jusii/amigahid-pico-UX/doc/images/ux-rev1-iso.png

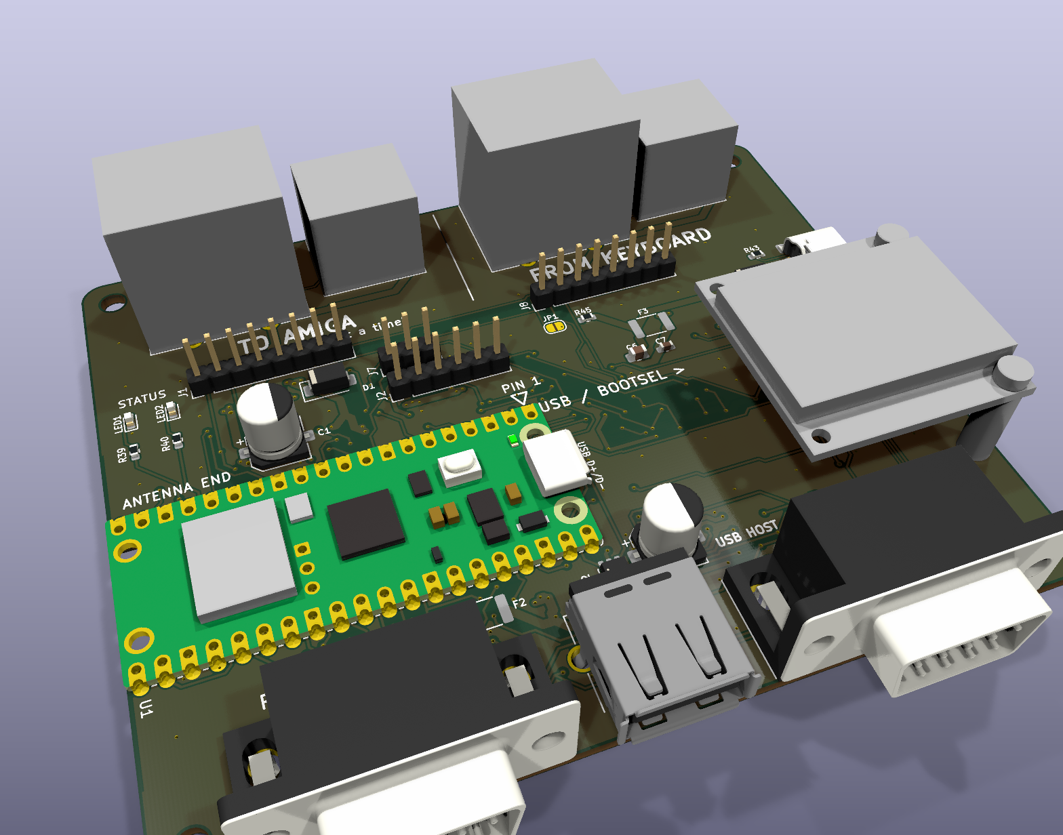
doc/images/ux-rev1-iso.png
