jusii/amigahid-pico-UX/kicad/rev6/mech/hid-pico-amiga-ux-rev1-assembly.step

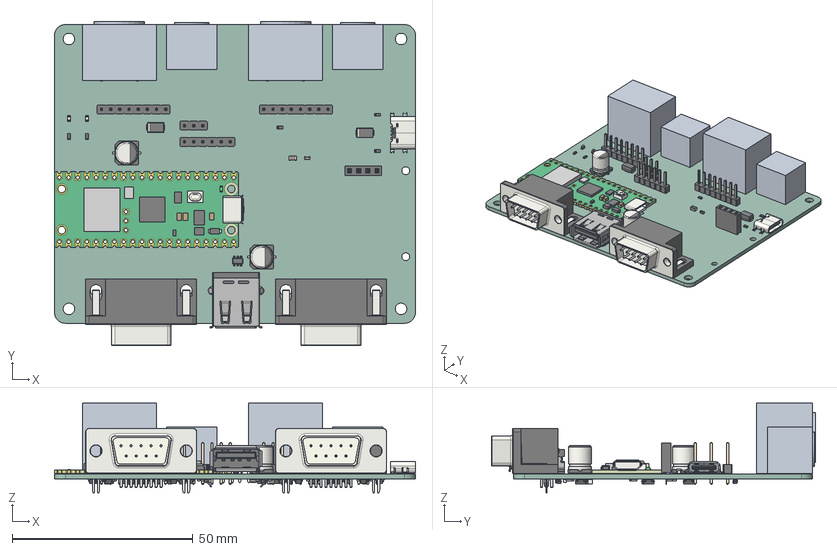
[picture p5: CAD file, 2026-09-28]
kicad/rev6/mech/hid-pico-amiga-ux-rev1-assembly.step
100.0 x 89.7 x 24.9 mm
R_0603_1608Metric x 45
DSUB-9_Pins_Horizontal_P2.77x2.84mm_EdgePinOffset7.70mm_Housed_ MountingHolesOffset9.12mm x 2
CP_Elec_63x77 x 2
PinSocket_1x04_P2.54mm_Vertical
SOT-23-6
USB_C_Receptacle_6P_TopMnt_Horizontal_GCT_USB4135-GF-A
RaspberryPi_Pico_W_Module_KiCad
C_0603_1608Metric x 3
C_0805_2012Metric x 2
LED_0603_1608Metric x 2
D_SMA x 2
PinHeader_1x03_P254mm_Vertical
PinHeader_1x08_P254mm_Vertical x 2
PinHeader_1x06_P254mm_Vertical
USB_A_Molex_67643_Horizontal
SOT-23 x 19
D_SOD-323 x 21
amigahid-pico-rev6_PCB
