jusii/amigahid-pico-UX/kicad/rev6/mech/hid-pico-amiga-ux-rev1-board.step

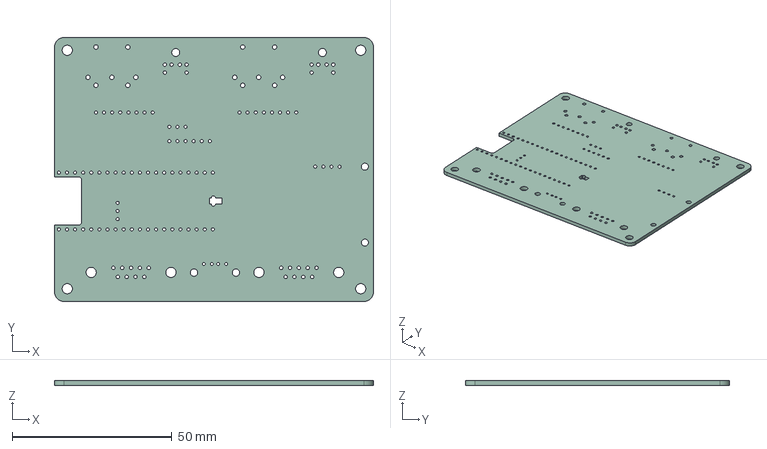
[picture p6: CAD file, 2026-09-28]
kicad/rev6/mech/hid-pico-amiga-ux-rev1-board.step
100.0 x 82.8 x 1.51 mm
