jusii/amigahid-pico-UX/(list of files, cad)

Other CAD files:
kicad/rev6/mech/hid-pico-amiga-ux-rev1-board.stl
