jusii/amigahid-pico-UX/kicad/rev6/fab/fit-check-1to1.pdf

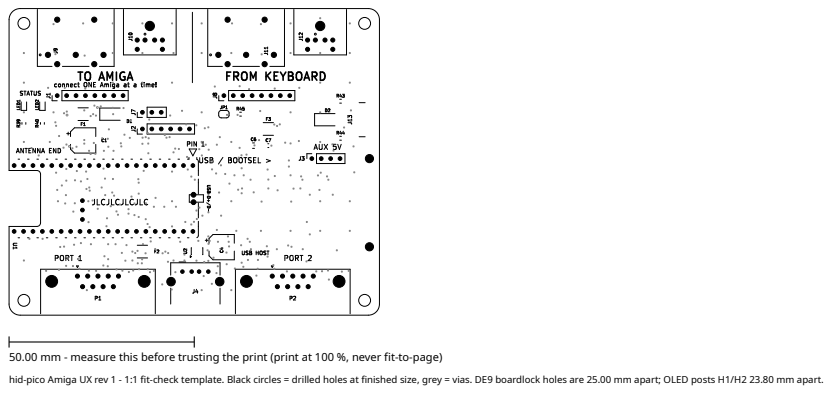
[picture p7: page 1]

50.00 mm - measure this before trusting the print (print at 100 %, never fit-to-page)
hid-pico Amiga UX rev 1 - 1:1 fit-check template. Black circles = drilled holes at finished size, grey = vias. DE9 boardlock holes are 25.00 mm apart; OLED posts H1/H2 23.80 mm apart.
