jusii/amigahid-pico-UX/kicad/rev6/amigahid-pico-rev6.kicad_pcb

## KiCad design kicad/rev6/amigahid-pico-rev6.kicad_pcb (2026-09-28)

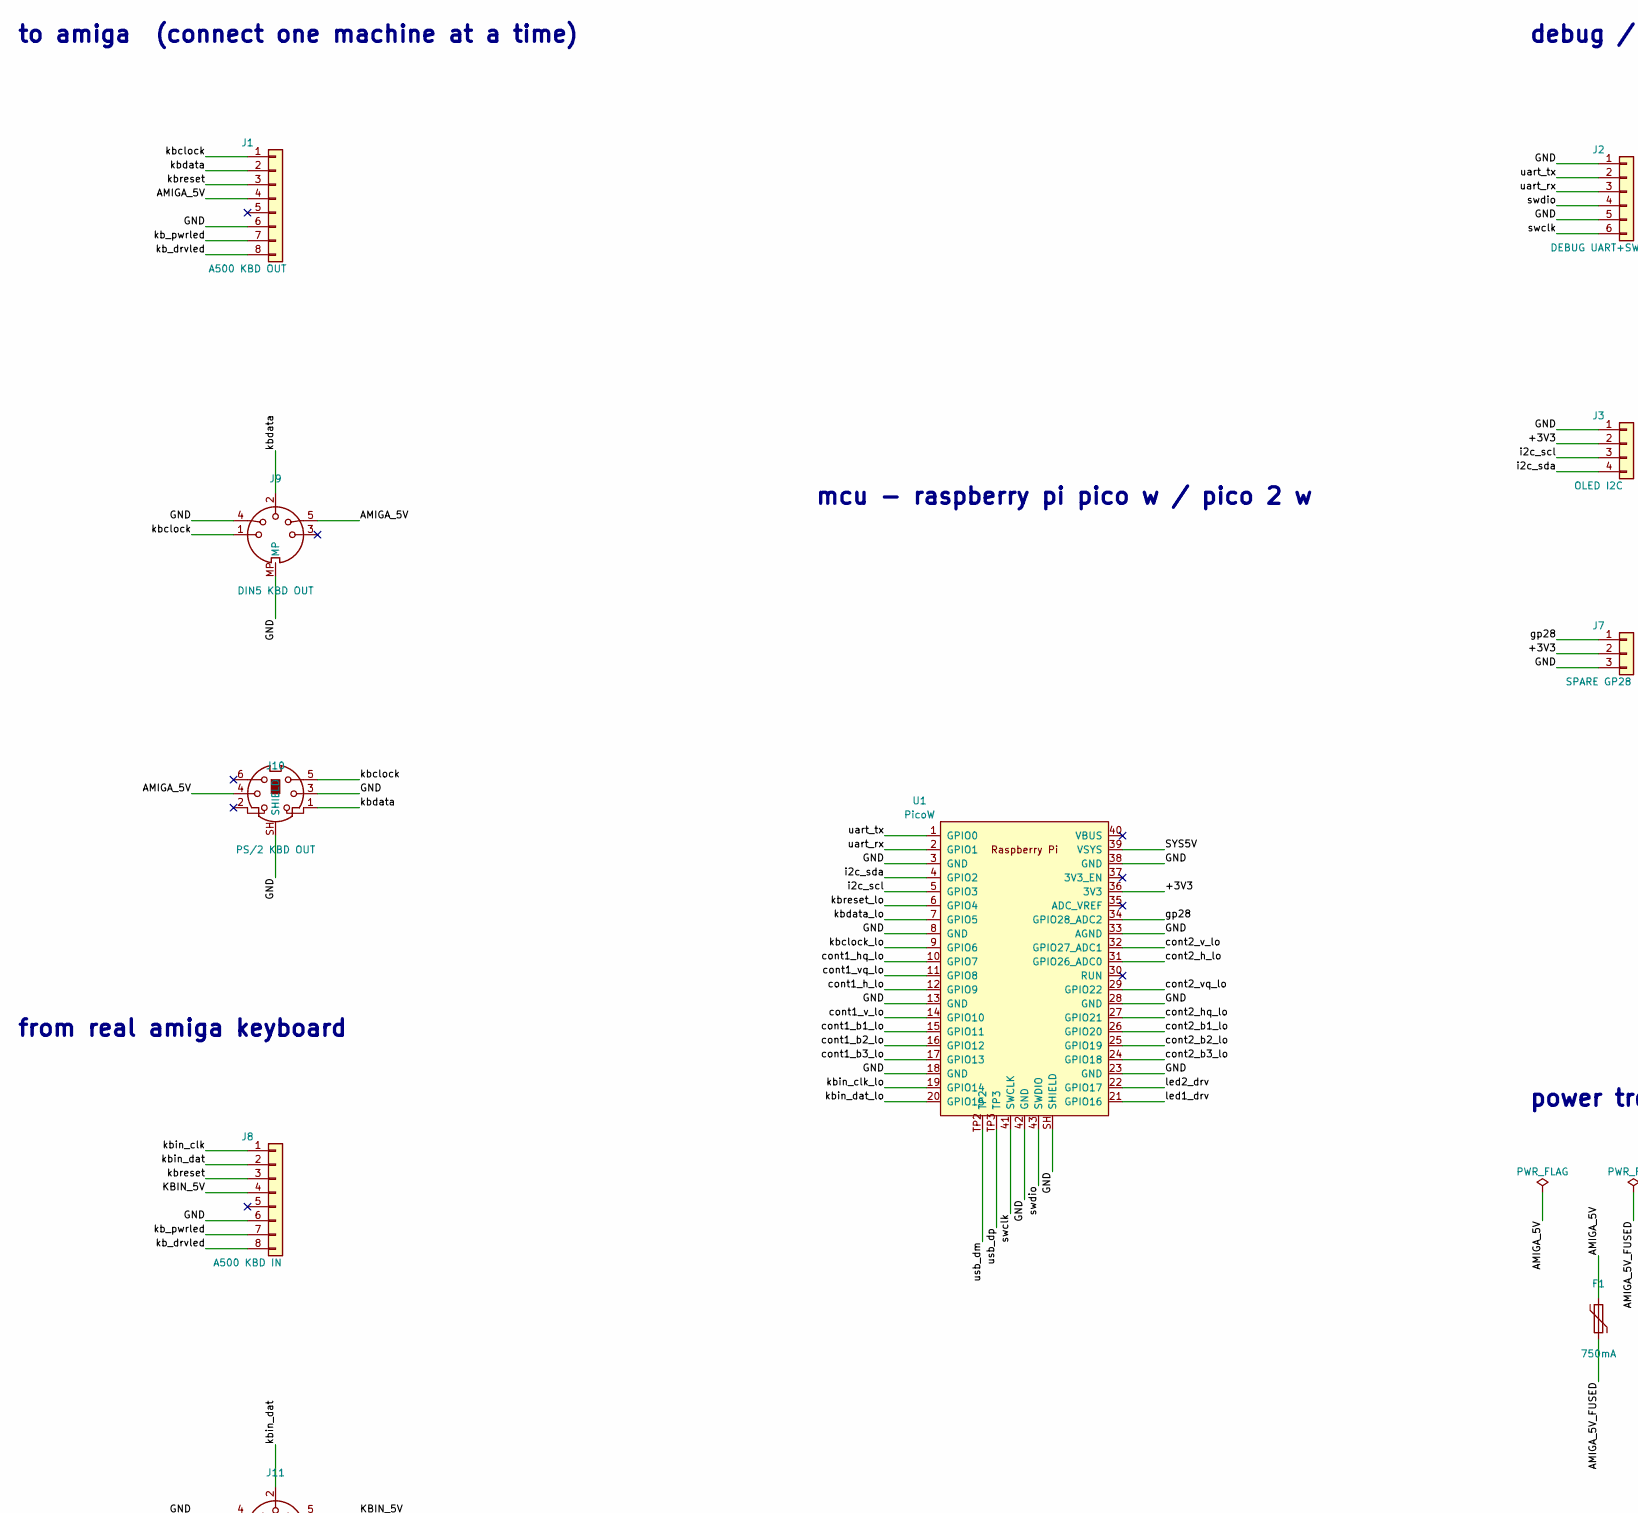
[picture p8: schematic amigahid-pico-rev6.kicad_sch, amiga keyboard adapter, part in row 1, column 1]

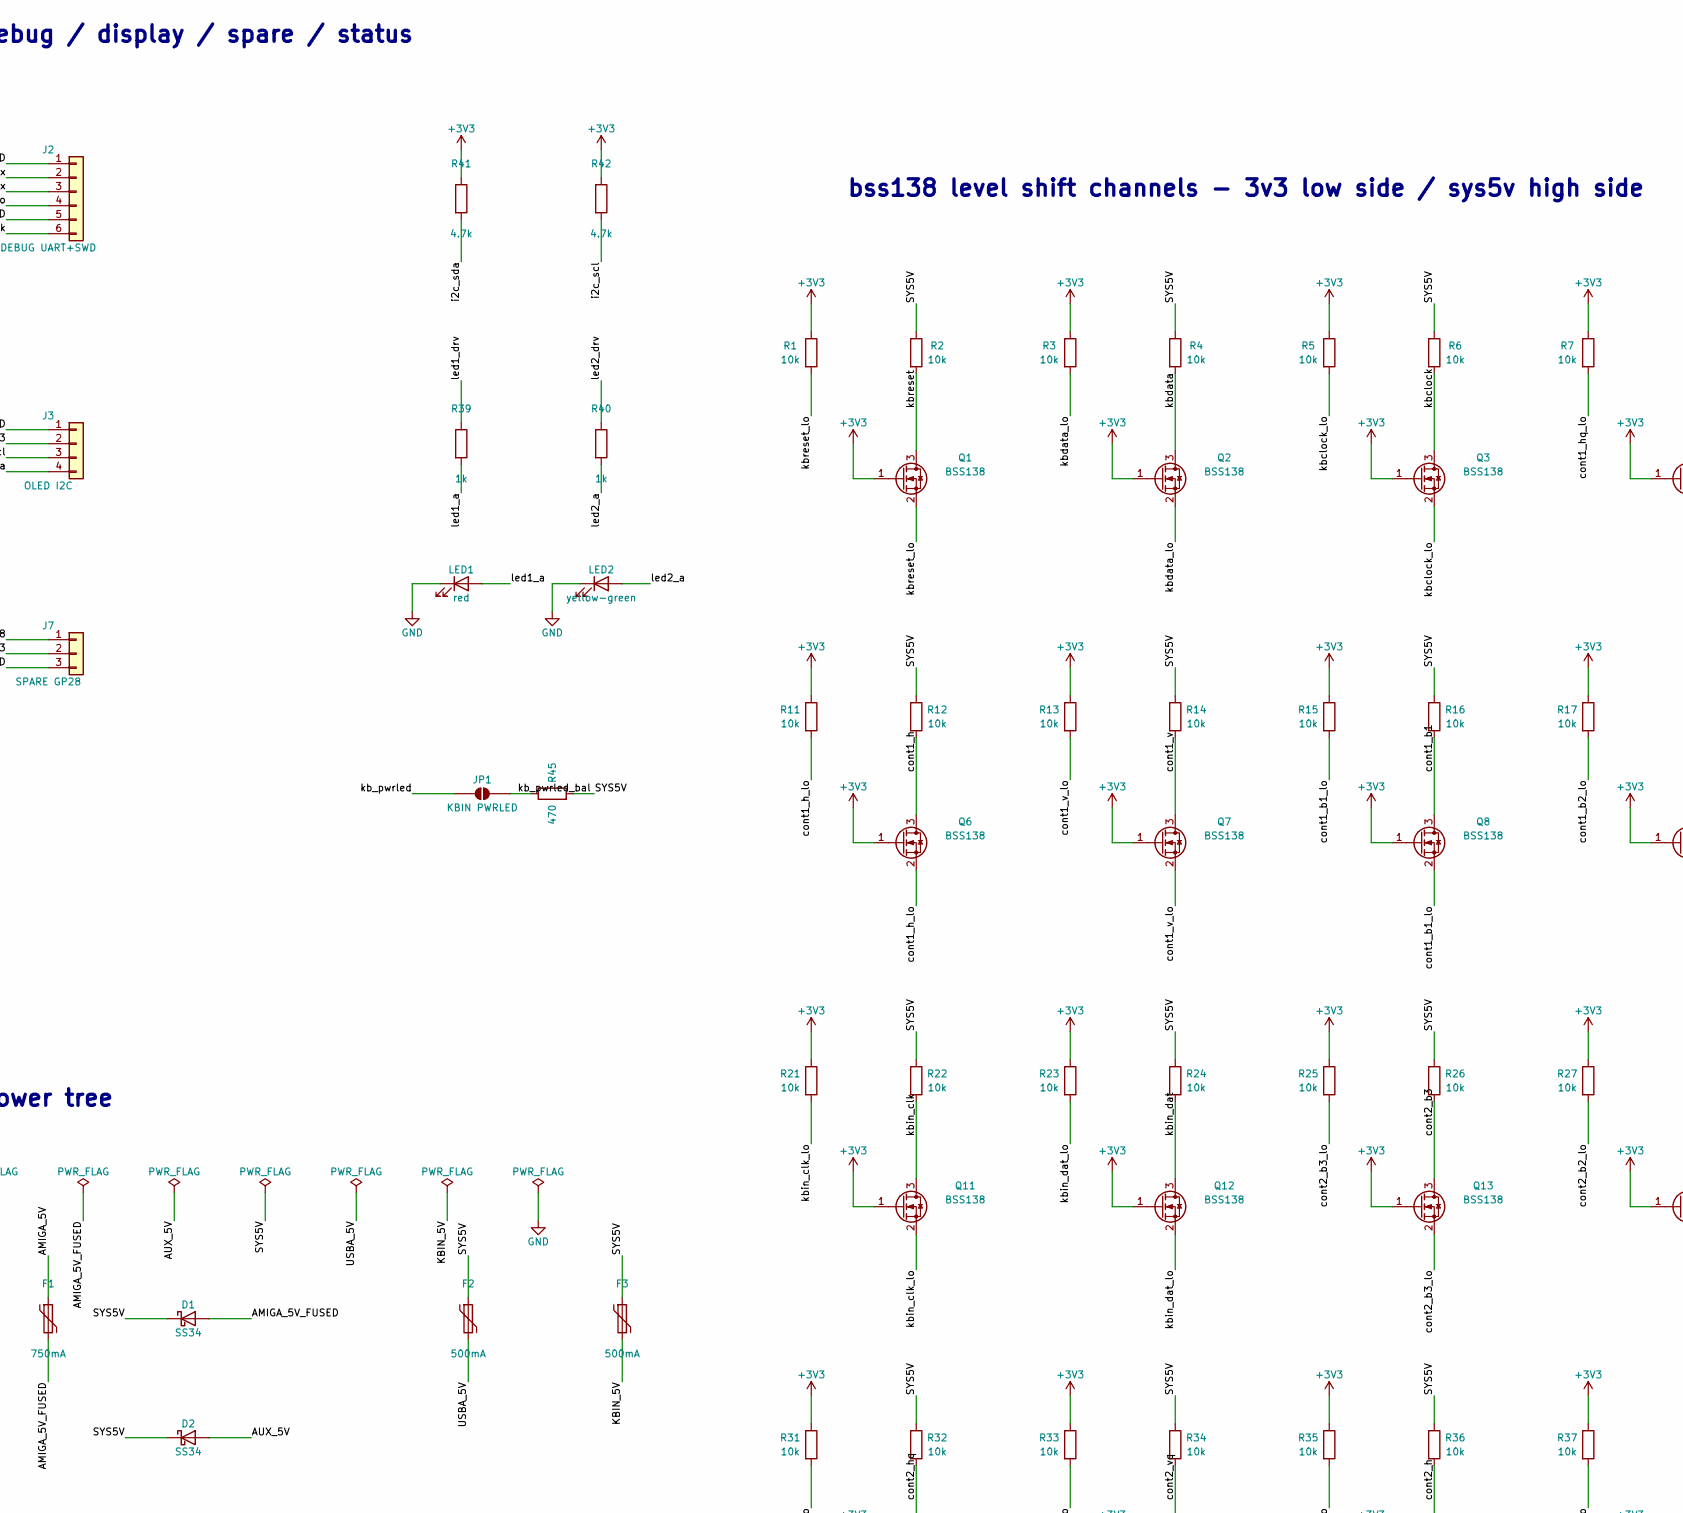
[picture p9: schematic amigahid-pico-rev6.kicad_sch, amiga keyboard adapter, part in row 1, column 2]

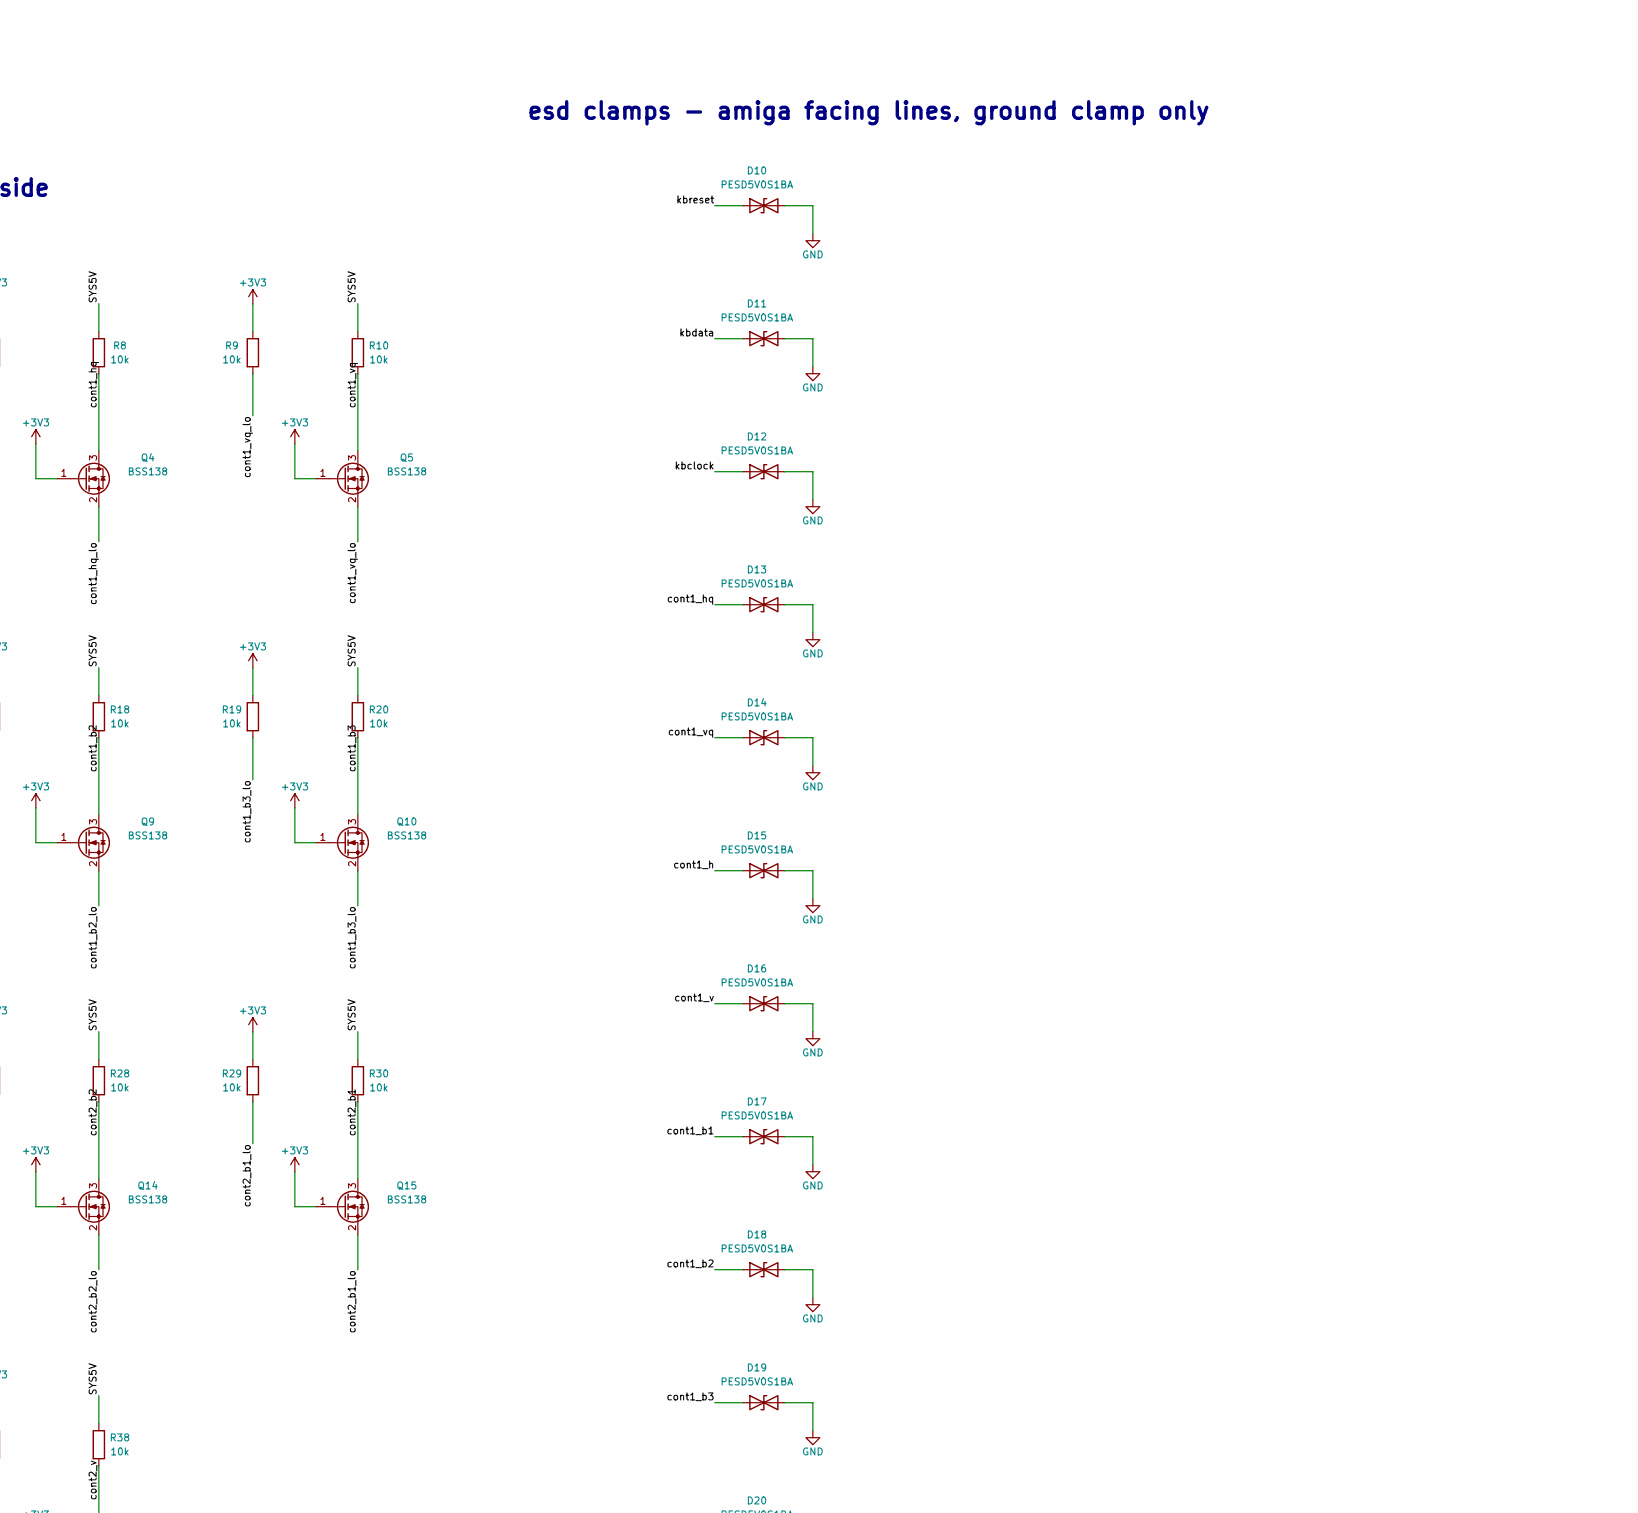
[picture p10: schematic amigahid-pico-rev6.kicad_sch, amiga keyboard adapter, part in row 1, column 3]

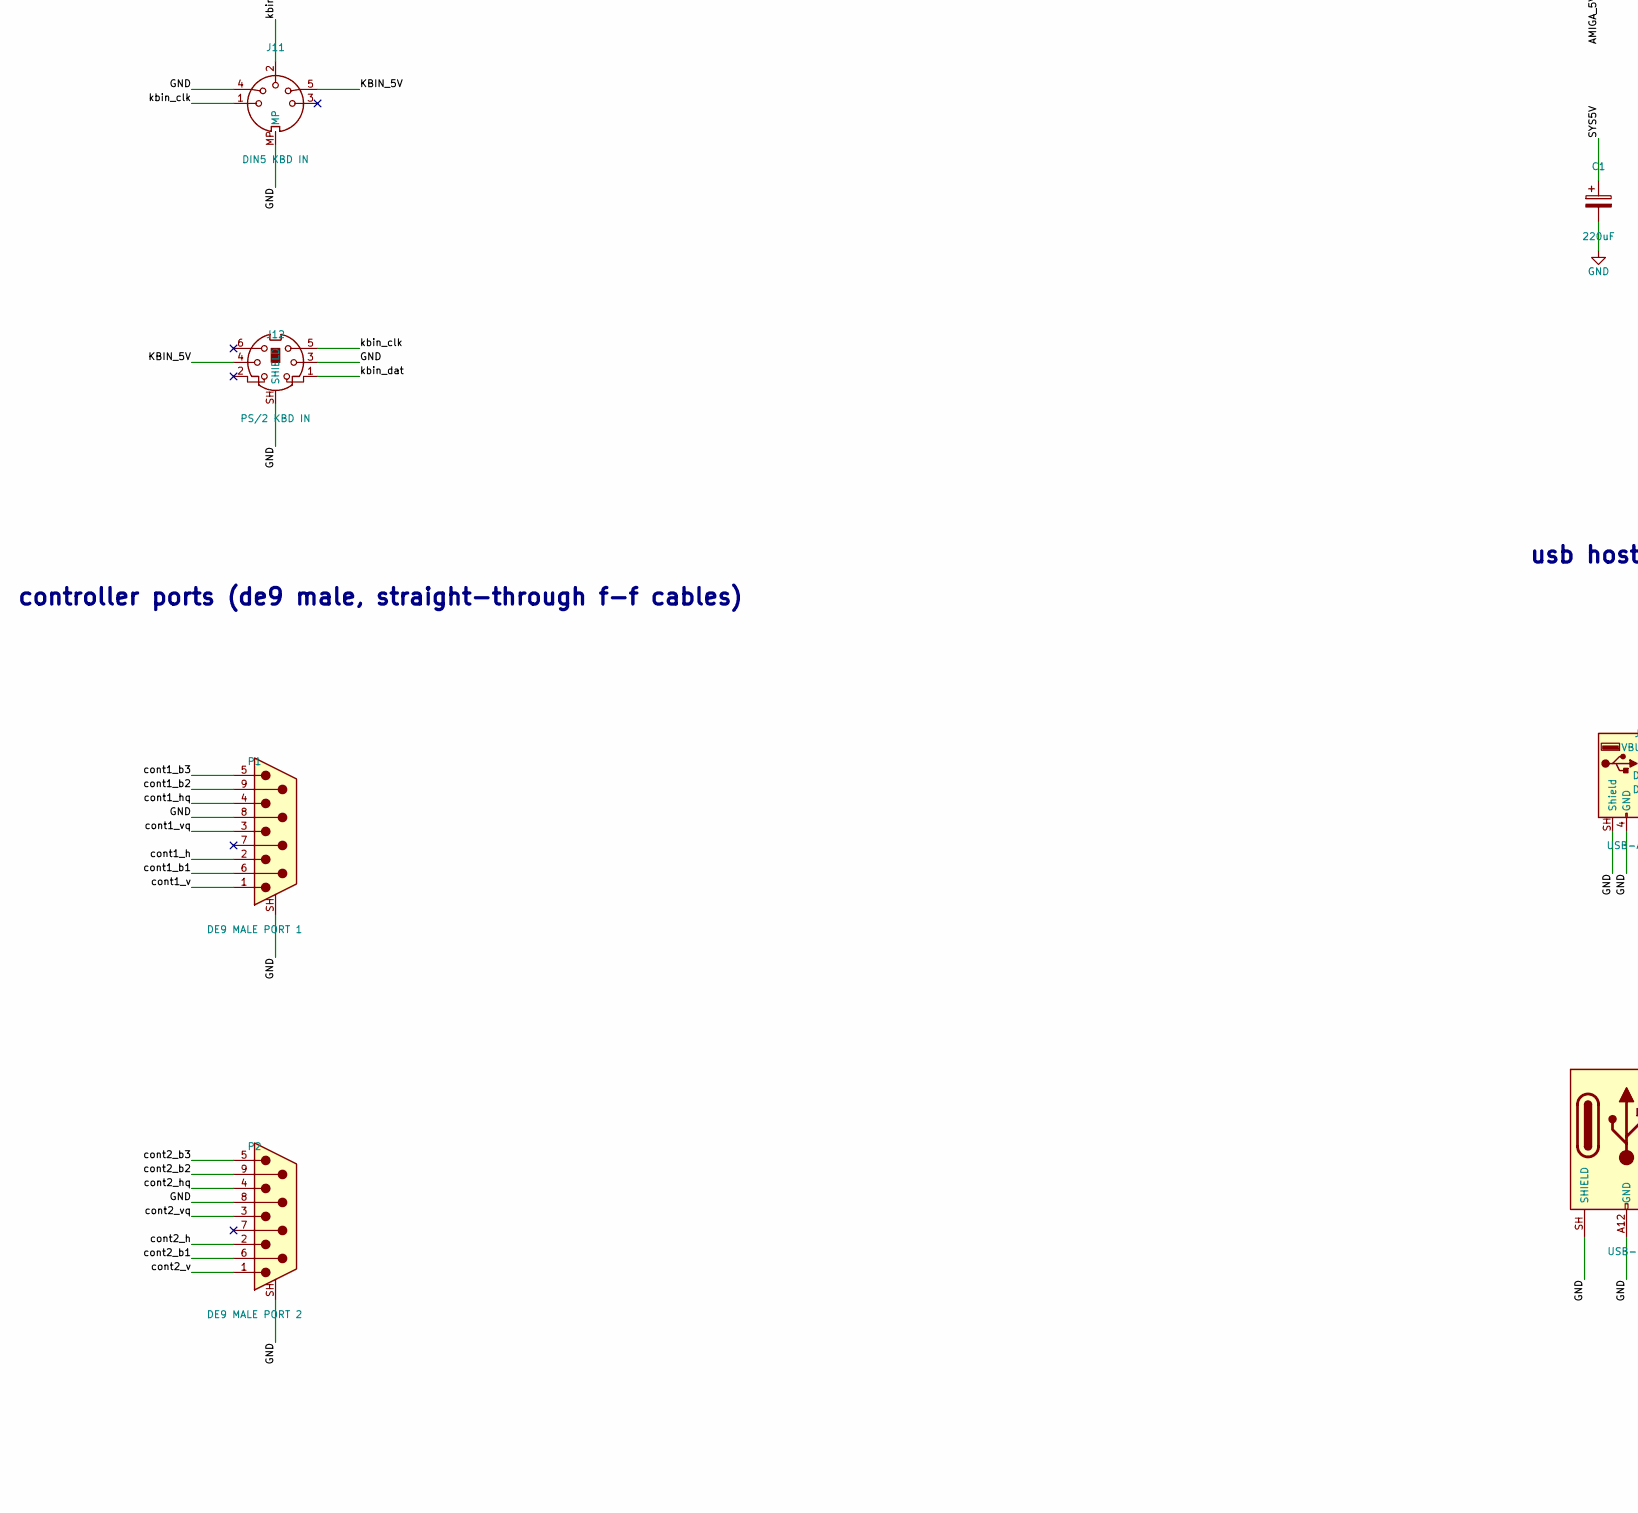
[picture p11: schematic amigahid-pico-rev6.kicad_sch, amiga keyboard adapter, part in row 2, column 1]

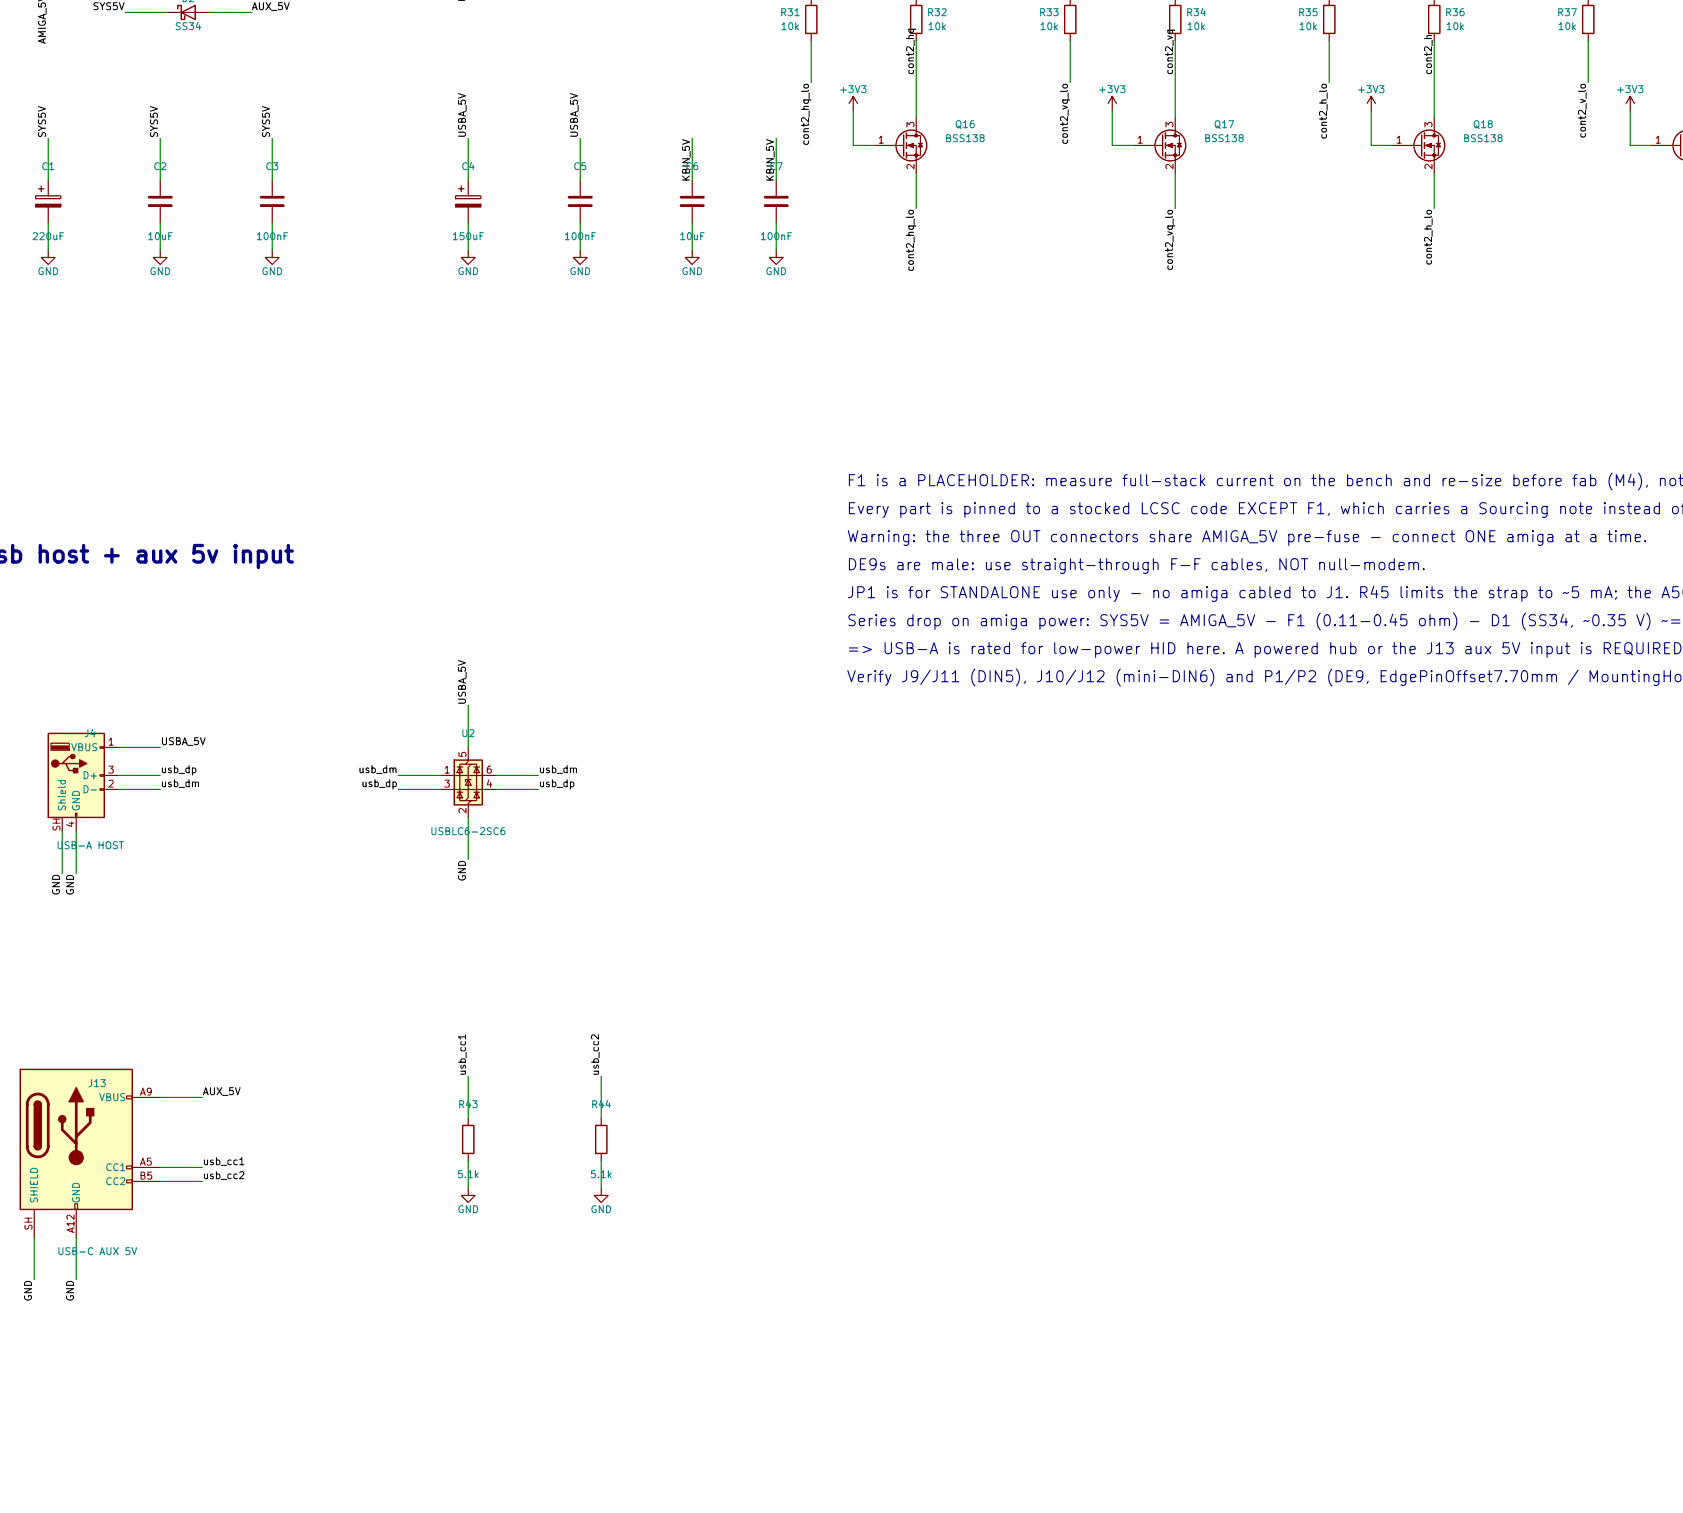
[picture p12: schematic amigahid-pico-rev6.kicad_sch, amiga keyboard adapter, part in row 2, column 2]

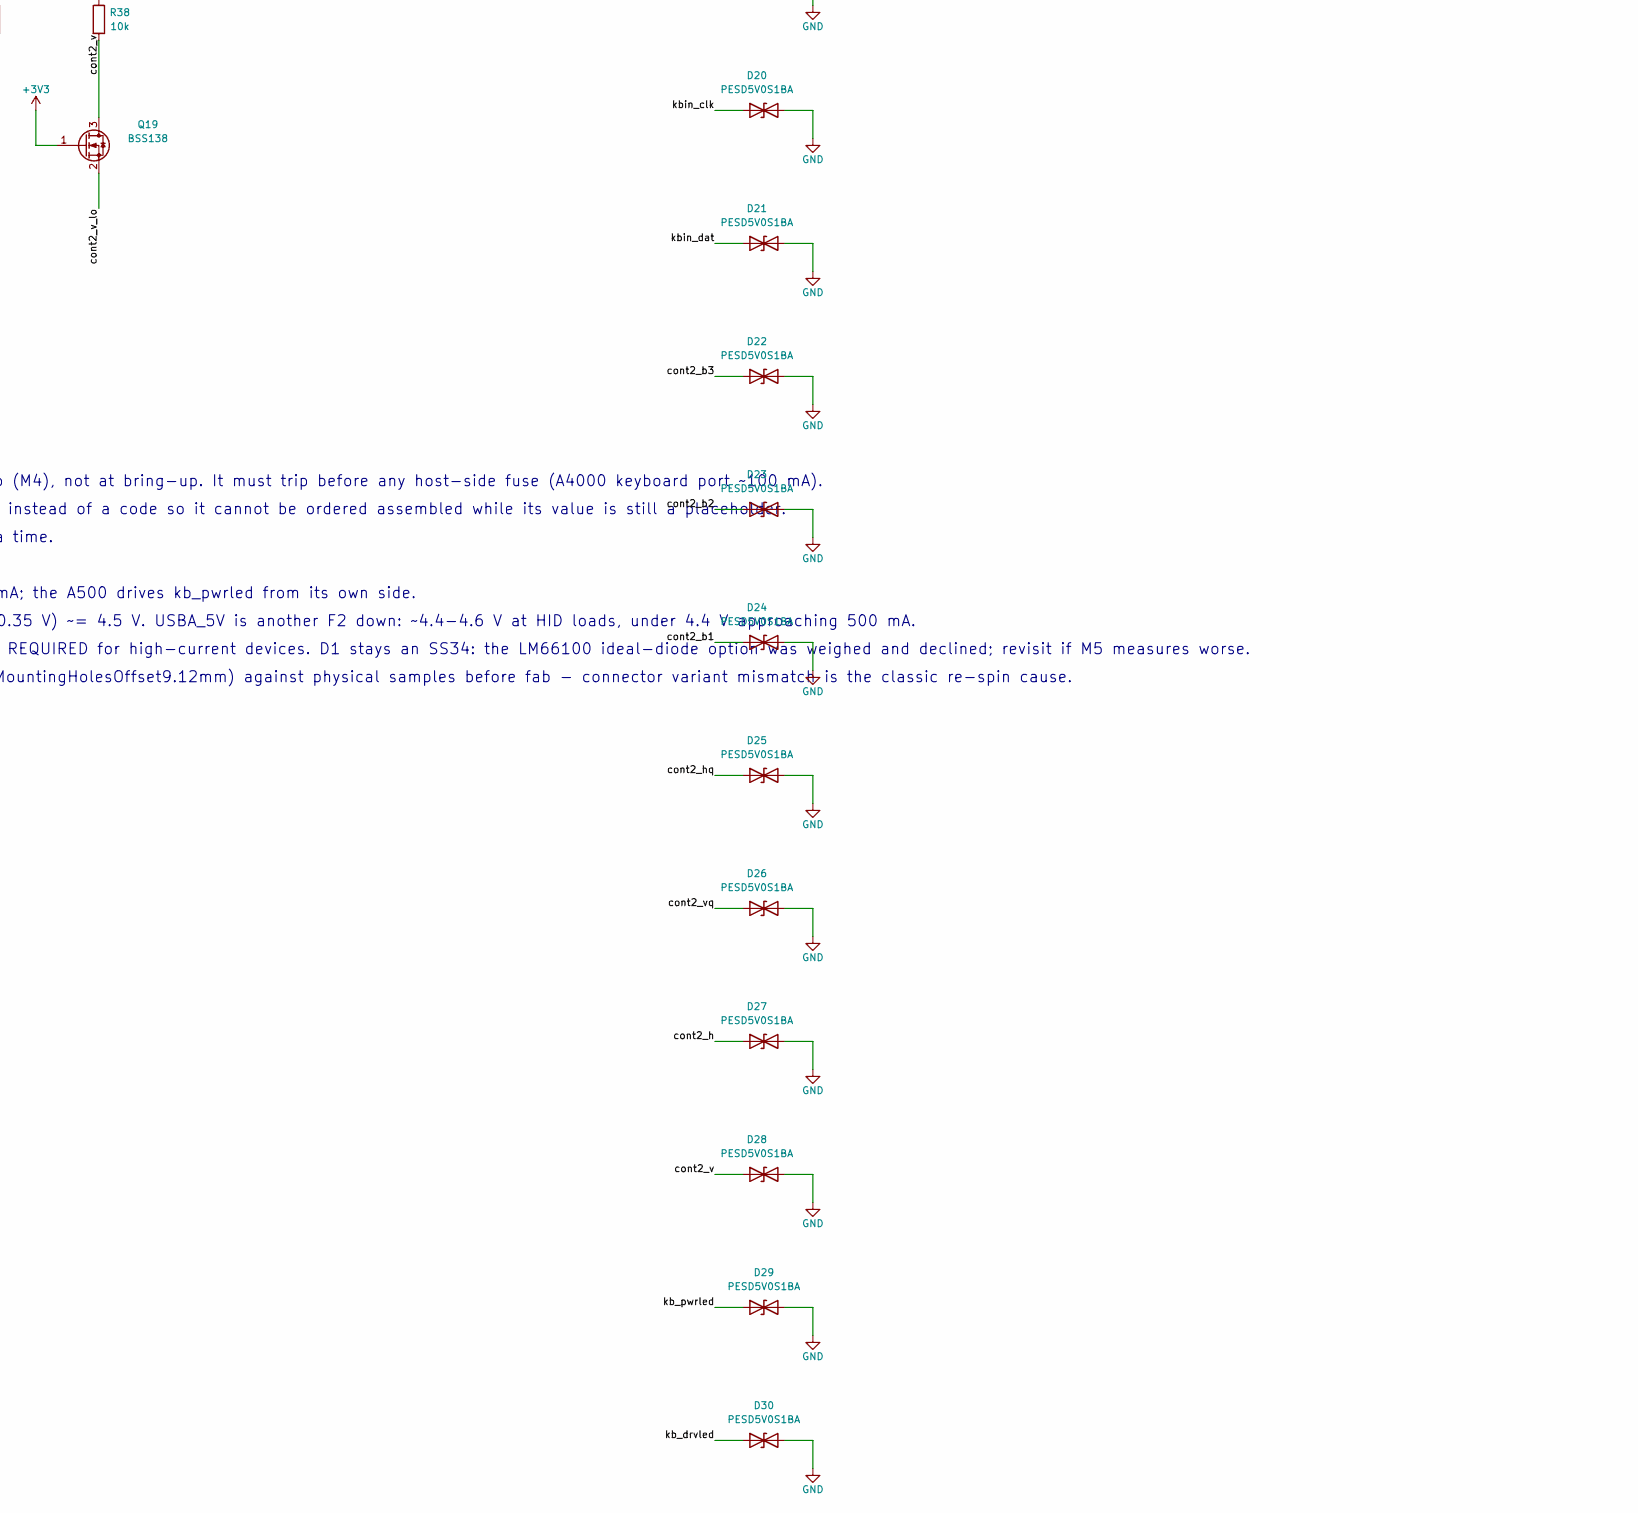
[picture p13: schematic amigahid-pico-rev6.kicad_sch, amiga keyboard adapter, part in row 2, column 3]

Parts:
C1: 220uF; CP_Elec_6.3x7.7; MPN EEE-FK1C221XP; LCSC C128533
C2, C6: 10uF; C_0805_2012Metric; LCSC C15850
C3, C5, C7: 100nF; C_0603_1608Metric; LCSC C14663
C4: 150uF; CP_Elec_6.3x7.7; MPN EEE-FKC151XAP; LCSC C413656
D1, D2: SS34; D_SMA; LCSC C8678
D10, D11, D12, D13, D14, D15, D16, D17, D18, D19, D20, D21, D22, D23, D24, D25, D26, D27, D28, D29, D30: PESD5V0S1BA; D_SOD-323; LCSC C19224
F1: 750mA; Fuse_1812_4532Metric; MPN MF-MSMF075-2
F2, F3: 500mA; Fuse_1812_4532Metric; MPN MF-MSMF050-2; LCSC C17313
J1: A500 KBD OUT; PinHeader_1x08_P2.54mm_Vertical
J2: DEBUG UART+SWD; PinHeader_1x06_P2.54mm_Vertical
J3: OLED I2C; PinSocket_1x04_P2.54mm_Vertical
J4: USB-A HOST; USB_A_Molex_67643_Horizontal
J7: SPARE GP28; PinHeader_1x03_P2.54mm_Vertical
J8: A500 KBD IN; PinHeader_1x08_P2.54mm_Vertical
J9: DIN5 KBD OUT; DIN5_180deg_Socket_Kycon_KCDX-5S-N
J10: PS/2 KBD OUT; MiniDIN6_PS2_Socket_CUI_MD-60S
J11: DIN5 KBD IN; DIN5_180deg_Socket_Kycon_KCDX-5S-N
J12: PS/2 KBD IN; MiniDIN6_PS2_Socket_CUI_MD-60S
J13: USB-C AUX 5V; USB_C_Receptacle_GCT_USB4135-GF-A_6P_TopMnt_Horizontal
JP1: KBIN PWRLED; SolderJumper-2_P1.3mm_Open_RoundedPad1.0x1.5mm
LED1: red; LED_0603_1608Metric; LCSC C2286
LED2: yellow-green; LED_0603_1608Metric; MPN KT-0603YG; LCSC C2289
P1: DE9 MALE PORT 1; DSUB-9_Pins_Horizontal_P2.77x2.84mm_EdgePinOffset7.70mm_Hou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
P2: DE9 MALE PORT 2; DSUB-9_Pins_Horizontal_P2.77x2.84mm_EdgePinOffset7.70mm_Hou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
Q1, Q2, Q3, Q4, Q5, Q6, Q7, Q8, Q9, Q10, Q11, Q12, Q13, Q14, Q15, Q16, Q17, Q18, Q19: BSS138; SOT-23; LCSC C78284
R1, R2, R3, R4, R5, R6, R7, R8, R9, R10, R11, R12, R13, R14, R15, R16, R17, R18, R19, R20, R21, R22, R23, R24, R25, R26, R27, R28, R29, R30, R31, R32, R33, R34, R35, R36, R37, R38: 10k; R_0603_1608Metric; LCSC C25804
R39, R40: 1k; R_0603_1608Metric; LCSC C21190
R41, R42: 4.7k; R_0603_1608Metric; LCSC C23162
R43, R44: 5.1k; R_0603_1608Metric; LCSC C23186
R45: 470; R_0603_1608Metric; LCSC C23179
U1: PicoW; RPi_PicoW_SMD_TH; MPN Raspberry Pi Pico W / Pico 2 W; LCSC n/a (module, hand fitted)
U2: USBLC6-2SC6; SOT-23-6; LCSC C7519

Connections:
+3V3: J3.2, J7.2, Q1.1 (G), Q2.1 (G), Q3.1 (G), Q4.1 (G), Q5.1 (G), Q6.1 (G), Q7.1 (G), Q8.1 (G), Q9.1 (G), Q10.1 (G), Q11.1 (G), Q12.1 (G), Q13.1 (G), Q14.1 (G), Q15.1 (G), Q16.1 (G), Q17.1 (G), Q18.1 (G), Q19.1 (G), R1.1, R3.1, R5.1, R7.1, R9.1, R11.1, R13.1, R15.1, R17.1, R19.1, R21.1, R23.1, R25.1, R27.1, R29.1, R31.1, R33.1, R35.1, R37.1, R41.1, R42.1, U1.36 (3V3)
/AMIGA_5V: F1.1, J1.4, J9.5, J10.4
/AMIGA_5V_FUSED: D1.2 (A), F1.2
/AUX_5V: D2.2 (A), J13.A9 (VBUS), J13.B9 (VBUS)
/KBIN_5V: C6.1, C7.1, F3.2, J8.4, J11.5, J12.4
/SYS5V: C1.1, C2.1, C3.1, D1.1 (K), D2.1 (K), F2.1, F3.1, R2.1, R4.1, R6.1, R8.1, R10.1, R12.1, R14.1, R16.1, R18.1, R20.1, R22.1, R24.1, R26.1, R28.1, R30.1, R32.1, R34.1, R36.1, R38.1, R45.2, U1.39 (VSYS)
/USBA_5V: C4.1, C5.1, F2.2, J4.1 (VBUS), U2.5 (VBUS)
/cont1_b1: D17.1 (A1), P1.6, Q8.3 (D), R16.2
/cont1_b1_lo: Q8.2 (S), R15.2, U1.15 (GPIO11)
/cont1_b2: D18.1 (A1), P1.9, Q9.3 (D), R18.2
/cont1_b2_lo: Q9.2 (S), R17.2, U1.16 (GPIO12)
/cont1_b3: D19.1 (A1), P1.5, Q10.3 (D), R20.2
/cont1_b3_lo: Q10.2 (S), R19.2, U1.17 (GPIO13)
/cont1_h: D15.1 (A1), P1.2, Q6.3 (D), R12.2
/cont1_h_lo: Q6.2 (S), R11.2, U1.12 (GPIO9)
/cont1_hq: D13.1 (A1), P1.4, Q4.3 (D), R8.2
/cont1_hq_lo: Q4.2 (S), R7.2, U1.10 (GPIO7)
/cont1_v: D16.1 (A1), P1.1, Q7.3 (D), R14.2
/cont1_v_lo: Q7.2 (S), R13.2, U1.14 (GPIO10)
/cont1_vq: D14.1 (A1), P1.3, Q5.3 (D), R10.2
/cont1_vq_lo: Q5.2 (S), R9.2, U1.11 (GPIO8)
/cont2_b1: D24.1 (A1), P2.6, Q15.3 (D), R30.2
/cont2_b1_lo: Q15.2 (S), R29.2, U1.26 (GPIO20)
/cont2_b2: D23.1 (A1), P2.9, Q14.3 (D), R28.2
/cont2_b2_lo: Q14.2 (S), R27.2, U1.25 (GPIO19)
/cont2_b3: D22.1 (A1), P2.5, Q13.3 (D), R26.2
/cont2_b3_lo: Q13.2 (S), R25.2, U1.24 (GPIO18)
/cont2_h: D27.1 (A1), P2.2, Q18.3 (D), R36.2
/cont2_h_lo: Q18.2 (S), R35.2, U1.31 (GPIO26_ADC0)
/cont2_hq: D25.1 (A1), P2.4, Q16.3 (D), R32.2
/cont2_hq_lo: Q16.2 (S), R31.2, U1.27 (GPIO21)
/cont2_v: D28.1 (A1), P2.1, Q19.3 (D), R38.2
/cont2_v_lo: Q19.2 (S), R37.2, U1.32 (GPIO27_ADC1)
/cont2_vq: D26.1 (A1), P2.3, Q17.3 (D), R34.2
/cont2_vq_lo: Q17.2 (S), R33.2, U1.29 (GPIO22)
/gp28: J7.1, U1.34 (GPIO28_ADC2)
/i2c_scl: J3.3, R42.2, U1.5 (GPIO3)
/i2c_sda: J3.4, R41.2, U1.4 (GPIO2)
/kb_drvled: D30.1 (A1), J1.8, J8.8
/kb_pwrled: D29.1 (A1), J1.7, J8.7, JP1.1 (A)
/kb_pwrled_bal: JP1.2 (B), R45.1
/kbclock: D12.1 (A1), J1.1, J9.1, J10.5, Q3.3 (D), R6.2
/kbclock_lo: Q3.2 (S), R5.2, U1.9 (GPIO6)
/kbdata: D11.1 (A1), J1.2, J9.2, J10.1, Q2.3 (D), R4.2
/kbdata_lo: Q2.2 (S), R3.2, U1.7 (GPIO5)
/kbin_clk: D20.1 (A1), J8.1, J11.1, J12.5, Q11.3 (D), R22.2
/kbin_clk_lo: Q11.2 (S), R21.2, U1.19 (GPIO14)
/kbin_dat: D21.1 (A1), J8.2, J11.2, J12.1, Q12.3 (D), R24.2
/kbin_dat_lo: Q12.2 (S), R23.2, U1.20 (GPIO15)
/kbreset: D10.1 (A1), J1.3, J8.3, Q1.3 (D), R2.2
/kbreset_lo: Q1.2 (S), R1.2, U1.6 (GPIO4)
/led1_a: LED1.2 (A), R39.2
/led1_drv: R39.1, U1.21 (GPIO16)
/led2_a: LED2.2 (A), R40.2
/led2_drv: R40.1, U1.22 (GPIO17)
/swclk: J2.6, U1.41 (SWCLK)
/swdio: J2.4, U1.43 (SWDIO)
/uart_rx: J2.3, U1.2 (GPIO1)
/uart_tx: J2.2, U1.1 (GPIO0)
/usb_cc1: J13.A5 (CC1), R43.1
/usb_cc2: J13.B5 (CC2), R44.1
/usb_dm: J4.2 (D-), U1.TP2, U2.1 (I/O1), U2.6 (I/O1)
/usb_dp: J4.3 (D+), U1.TP3, U2.3 (I/O2), U2.4 (I/O2)
GND: C1.2, C2.2, C3.2, C4.2, C5.2, C6.2, C7.2, D10.2 (A2), D11.2 (A2), D12.2 (A2), D13.2 (A2), D14.2 (A2), D15.2 (A2), D16.2 (A2), D17.2 (A2), D18.2 (A2), D19.2 (A2), D20.2 (A2), D21.2 (A2), D22.2 (A2), D23.2 (A2), D24.2 (A2), D25.2 (A2), D26.2 (A2), D27.2 (A2), D28.2 (A2), D29.2 (A2), D30.2 (A2), J1.6, J2.1, J2.5, J3.1, J4.4 (GND), J4.SH (Shield), J7.3, J8.6, J9.4, J9.MP, J10.3, J10.SH (SHIELD), J11.4, J11.MP, J12.3, J12.SH (SHIELD), J13.A12 (GND), J13.B12 (GND), J13.SH (SHIELD), LED1.1 (K), LED2.1 (K), P1.8, P1.SH (PAD), P2.8, P2.SH (PAD), R43.2, R44.2, U1.3 (GND), U1.8 (GND), U1.13 (GND), U1.18 (GND), U1.23 (GND), U1.28 (GND), U1.33 (AGND), U1.38 (GND), U1.42 (GND), U1.SH (SHIELD), U2.2 (GND)

Notes on the sheet:
mcu - raspberry pi pico w / pico 2 w
to amiga (connect one machine at a time)
from real amiga keyboard
controller ports (de9 male, straight-through f-f cables)
debug / display / spare / status
power tree
usb host + aux 5v input
bss138 level shift channels - 3v3 low side / sys5v high side
esd clamps - amiga facing lines, ground clamp only
F1 is a PLACEHOLDER: measure full-stack current on the bench and re-size before fab (M4), not at bring-up. It must trip before any host-side fuse (A4000 keyboard port ~100 mA).
Every part is pinned to a stocked LCSC code EXCEPT F1, which carries a Sourcing note instead of a code so it cannot be ordered assembled while its value is still a placeholder.
Warning: the three OUT connectors share AMIGA_5V pre-fuse - connect ONE amiga at a time.
DE9s are male: use straight-through F-F cables, NOT null-modem.
JP1 is for STANDALONE use only - no amiga cabled to J1. R45 limits the strap to ~5 mA; the A500 drives kb_pwrled from its own side.
Series drop on amiga power: SYS5V = AMIGA_5V - F1 (0.11-0.45 ohm) - D1 (SS34, ~0.35 V) ~= 4.5 V. USBA_5V is another F2 down: ~4.4-4.6 V at HID loads, under 4.4 V approaching 500 mA.
=> USB-A is rated for low-power HID here. A powered hub or the J13 aux 5V input is REQUIRED for high-current devices. D1 stays an SS34: the LM66100 ideal-diode option was weighed and declined; revisit if M5 measures worse.
Verify J9/J11 (DIN5), J10/J12 (mini-DIN6) and P1/P2 (DE9, EdgePinOffset7.70mm / MountingHolesOffset9.12mm) against physical samples before fab - connector variant mismatch is the classic re-spin cause.

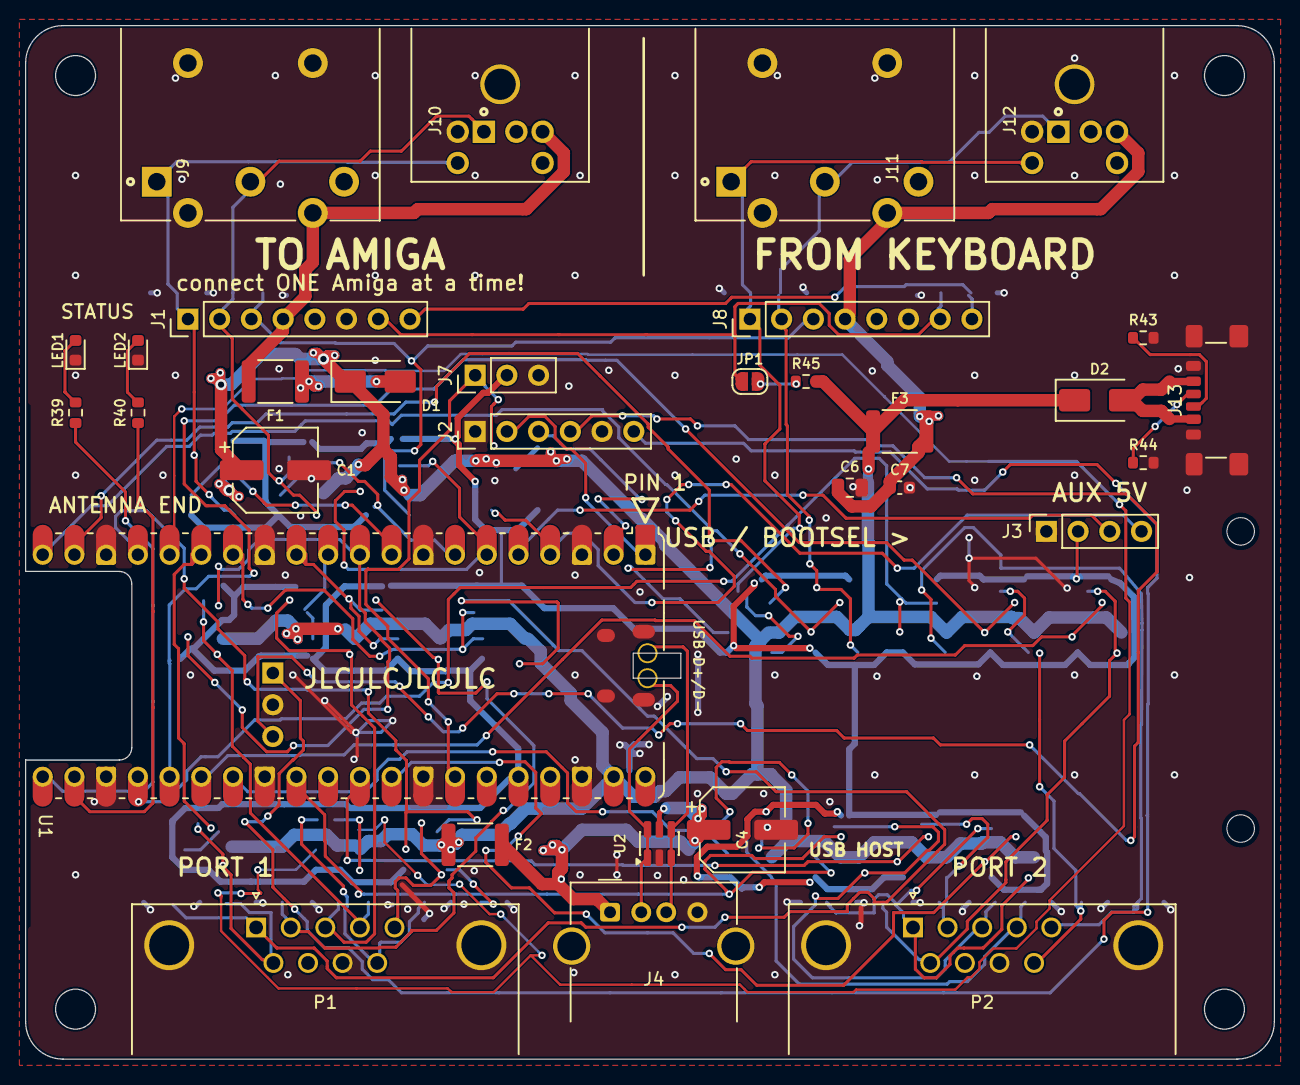
[picture p14: board amigahid-pico-rev6.kicad_pcb from above]

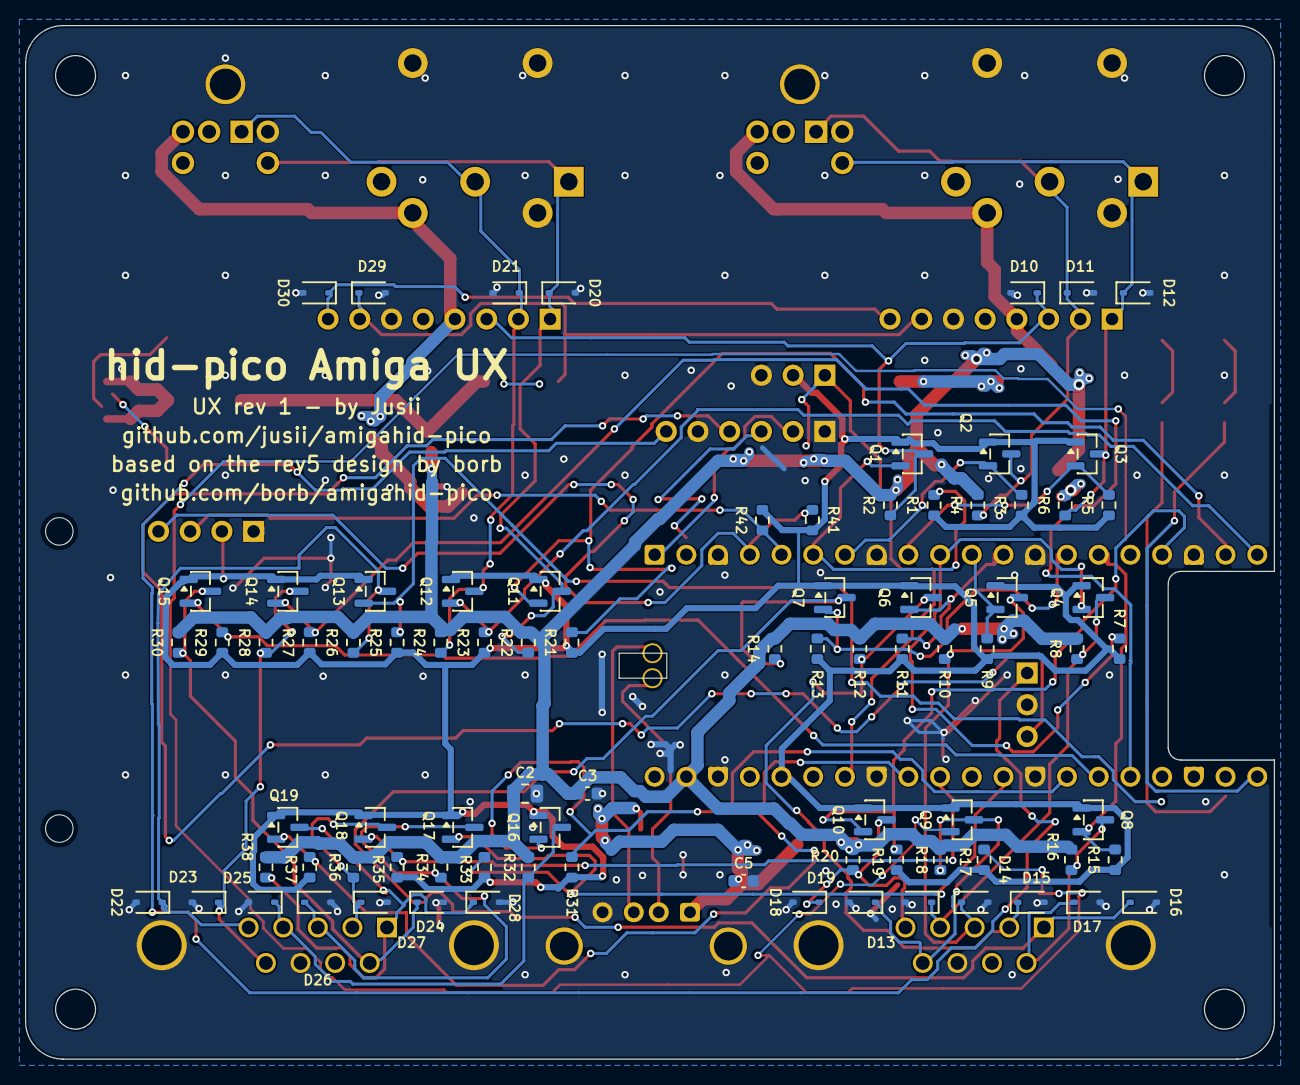
[picture p15: board amigahid-pico-rev6.kicad_pcb from below]

Board: 2 copper layers, 100.0 x 82.8 mm, 117 parts (83 on the bottom side), 64 nets.

Other parts of the board:
H1, H2: M2 OLED post; MountingHole_2.2mm_M2
