jusii/amigahid-pico-UX/src/config.h

/**
 * this file is part of amigahid-pico, (c) 2021 just nine <nine@aphlor.org>
 * please locate the full source at https://github.com/borb/amigahid-pico
 *
 * released under the terms of the Eclipse Public License 2.0 (EPL-2.0).
 * please find the complete license text at https://spdx.org/licenses/EPL-2.0
 *
 * hid-pico configuration
 *
 * PLEASE NOTE ALL PIN DESIGNATIONS ARE GPIO PIN NUMBERS - NOT PHYSICAL PIN NUMBERS
 */

#ifndef _CONFIG_H
#define _CONFIG_H

#if defined(BOARD_HIDPICO_REV2)
#  define HAS_SCREEN
#  define HAS_KEYBOARD
#  define HAS_PORT1
#  define HAS_PORT2

#  define I2C_PORT      i2c0
#  define I2C_PIN_SDA   4
#  define I2C_PIN_SCL   5
#  define I2C_IRQN      23

#  define KBD_AMIGA_RST 10
#  define KBD_AMIGA_DAT 11
#  define KBD_AMIGA_CLK 12

#  define QM1_AMIGA_HQ  7
#  define QM1_AMIGA_VQ  6
#  define QM1_AMIGA_H   9
#  define QM1_AMIGA_V   8
#  define QM1_AMIGA_B1  22
#  define QM1_AMIGA_B2  26
#  define QM1_AMIGA_B3  27

#  ifdef PORT2_ROLE_KEYBOARD
#    error PORT2_ROLE=KEYBOARD pin mapping is not defined for REV2 yet
#  endif
#elif defined(BOARD_HIDPICO_REV4)
#  define HAS_SCREEN
#  define HAS_KEYBOARD
#  define HAS_PORT1
#  define HAS_PORT2

#  define I2C_PORT      i2c1
#  define I2C_PIN_SDA   2
#  define I2C_PIN_SCL   3
#  define I2C_IRQN      24 // this is tied to the i2c port being used so get the right one!

#  define KBD_AMIGA_RST 4
#  define KBD_AMIGA_DAT 5
#  define KBD_AMIGA_CLK 6

#  define QM1_AMIGA_HQ  7
#  define QM1_AMIGA_VQ  8
#  define QM1_AMIGA_H   9
#  define QM1_AMIGA_V   10
#  define QM1_AMIGA_B1  11
#  define QM1_AMIGA_B2  12
#  define QM1_AMIGA_B3  13

#  ifdef PORT2_ROLE_KEYBOARD
// controller port 2 is repurposed as a real amiga keyboard input. these are
// the existing port 2 'h' and 'v' gpios (kicad nets: lcont2 h / lcont2 v),
// reusing their bss138 level shifters. wired to a real keyboard, not the amiga.
#    define HAS_KBD_IN
#    define KBD_REAL_CLK 26 // port 2 'h' line -> real keyboard kclk (pico input)
#    define KBD_REAL_DAT 27 // port 2 'v' line -> real keyboard kdat (bidirectional)
#  endif
#elif defined(BOARD_HIDPICO_REV6)
#  define HAS_SCREEN
#  define HAS_KEYBOARD
#  define HAS_PORT1
#  define HAS_PORT2

#  define I2C_PORT      i2c1
#  define I2C_PIN_SDA   2
#  define I2C_PIN_SCL   3

#  define KBD_AMIGA_RST 4
#  define KBD_AMIGA_DAT 5
#  define KBD_AMIGA_CLK 6

#  define QM1_AMIGA_HQ  7
#  define QM1_AMIGA_VQ  8
#  define QM1_AMIGA_H   9
#  define QM1_AMIGA_V   10
#  define QM1_AMIGA_B1  11
#  define QM1_AMIGA_B2  12
#  define QM1_AMIGA_B3  13

// rev6 has a dedicated real amiga keyboard input on its own level shifters,
// so controller port 2 is left free for (future) joystick emulation.
#  define HAS_KBD_IN
#  define KBD_REAL_CLK  14 // real keyboard kclk (pico input)
#  define KBD_REAL_DAT  15 // real keyboard kdat (bidirectional)

#  define HAS_STATUS_LEDS
#  define LED_STATUS1   16
#  define LED_STATUS2   17

#  ifdef PORT2_ROLE_KEYBOARD
#    error PORT2_ROLE=KEYBOARD is not applicable to REV6 (keyboard input is dedicated)
#  endif
#else
#  error Board type has not been defined; check cmake command line
#endif

#endif // _CONFIG_H
