jusii/amigahid-pico-UX/src/platform/amiga/keyboard_recv.h

/**
 * this file is part of amigahid-pico, (c) 2021 just nine <nine@aphlor.org>
 * please locate the full source at https://github.com/borb/amigahid-pico
 *
 * released under the terms of the Eclipse Public License 2.0 (EPL-2.0).
 * please find the complete license text at https://spdx.org/licenses/EPL-2.0
 *
 * real amiga keyboard receive path (boards with HAS_KBD_IN).
 */

#ifndef _PLATFORM_AMIGA_KEYBOARD_RECV_H
#define _PLATFORM_AMIGA_KEYBOARD_RECV_H

/**
 * @brief Set up the PIO receiver for a physically attached real amiga keyboard.
 *
 * Claims a PIO state machine that clocks in keycodes from a physically
 * attached amiga keyboard and drives the protocol handshake autonomously.
 * No-op on boards without HAS_KBD_IN.
 */
void amiga_keyboard_recv_init(void);

/**
 * @brief Drain any received keycodes and inject them into the amiga output.
 *
 * Call from the main loop. Decodes bytes received from the real keyboard and
 * forwards decoded keys to the shared keyboard event queue (the same merge
 * point the USB/BT path feeds). No-op on boards without HAS_KBD_IN.
 */
void amiga_keyboard_recv_task(void);

#endif // _PLATFORM_AMIGA_KEYBOARD_RECV_H
