jusii/amigahid-pico-UX/(commit log)

2026-07-02 platform/amiga: add real Amiga keyboard input on controller port 2
    Build with -DPORT2_ROLE=KEYBOARD to repurpose controller port 2 as an
    input for a physically attached Amiga keyboard. A PIO state machine
    receives the keyboard's serial protocol (keyboard is clock master) and
    drives the handshake pulse autonomously; received keycodes are injected
    into the existing send queue so they merge with USB/Bluetooth input.
    Default remains PORT2_ROLE=JOYSTICK, which builds identically to
    before. REV4 pin mapping only (gpio 26/27); REV2 refuses the option at
    compile time. Wiring and configuration are documented in
    doc/hardware.md and doc/installation.md.
2026-07-02 doc: fix stale notes and build command; describe this fork
    Replace the outdated README note (port 2 pin mappings now exist in the
    source tree), add a fork note describing the real-keyboard feature and
    the PR #44 provenance, and fix the broken build command in the
    installation guide (cd build && cmake --build build/ referenced a
    nonexistent path).
2026-08-04 platform: add REV6 board target with dedicated keyboard input pins
    REV6 keeps the REV4 pin map (i2c1 on 2/3, amiga keyboard out on 4/5/6,
    controller port 1 on 7-13) and adds a dedicated real amiga keyboard input
    on gp14/15 plus two status leds on gp16/17. HAS_KBD_IN marks a board that
    can receive from a real keyboard, HAS_STATUS_LEDS a board with the leds.
    Because the keyboard input has its own pins and level shifters on REV6,
    controller port 2 is never repurposed for it: PORT2_ROLE=KEYBOARD is
    rejected at configure time (and by #error if it reaches config.h). REV4
    keeps the option, so PORT2_ROLE=KEYBOARD now also sets HAS_KBD_IN there.
    Also drop the vestigial I2C_IRQN from the new block (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
2026-08-04 platform/amiga: gate real keyboard input on HAS_KBD_IN
    The receive path was gated on PORT2_ROLE_KEYBOARD, which describes how
    REV4 gets a keyboard input rather than whether the board has one at all.
    Switch main.c and keyboard_recv.c to HAS_KBD_IN, which config.h derives
    per board, so REV6's dedicated pins work without pretending port 2 has
    been repurposed.
    keyboard_recv.c and its pio header are now built unconditionally; the
    existing self-stub compiles the module away on boards without a keyboard
    input, which keeps the cmake side free of role-dependent sources.
2026-08-04 build: infer rp2350 platform for pico2 boards
    PICO_PLATFORM defaulted to rp2040 regardless of PICO_BOARD, so building
    for a pico 2 needed both variables set or the sdk picked the wrong chip.
    Resolve the board first and default the platform from it: pico2 and
    pico2_w select rp2350-arm-s, everything else keeps rp2040. An explicit
    PICO_PLATFORM on the command line still wins.
2026-08-04 platform/amiga: forward hard reset from real keyboard kclk hold
    A real Amiga keyboard demands a hard reset by holding KCLK low for at
    least 500ms, which on big-box machines is the only reset signalling
    there is. The PIO receiver only sees silence, so that reset used to die
    at the board.
    Poll KCLK from the receive task and, once it has been continuously low
    for KBDIN_RESET_HOLD_MS (250ms by default, overridable at build time
    for bench tuning), forward the hold through the new amiga_kbdin_reset().
    That drives exactly what a held ctrl-amiga-amiga drives - /rst low plus
    the outgoing clock held low - so A500-style and big-box targets are both
    covered.
    The combo path already asserts reset from t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
2026-08-04 util: add status led support
    rev6 breaks out two status leds (gpio 16/17) so the adapter can say what
    it is doing without a serial console or an oled panel attached. led 1
    heartbeats until a usb or bluetooth device mounts and then sits solid;
    led 2 flashes briefly per input event handed to the amiga, replaced by a
    faster blink whilst bluetooth is showing a pairing prompt.
    The task is time-sliced off the millisecond clock and runs from the main
    loop; the event hooks only latch state, so the hid callbacks stay cheap.
    Every entry point is core0-only - core1 is busy with the quadrature mouse
    output loop and does not touch the leds.
    Boards without HAS_STATUS_LEDS get empty static inline stubs,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
2026-08-04 ci: add rev6 and keyboard-input build variants
    extend the build matrix with include entries for the real-keyboard and rev6
    targets: rev4 with PORT2_ROLE=KEYBOARD, rev6 on a plain pico, rev6 on pico w
    with the bluetooth hid host (plus an sh1106 display variant) and rev6 on
    pico 2 w. the base 2x2 cross-product is untouched; the variant/cmake-args
    keys carry the extra flags and keep artifact names unique.
    also run on the fork's working branches and on workflow_dispatch.
2026-08-04 platform/amiga: make real keyboard reset handling survive its own reset
    Three problems with the KCLK hold path, all of which land on a real
    keyboard ctrl-amiga-amiga - the case the feature exists for.
    The state machine restart was reachable only from the hold-release edge,
    and that edge is routinely missed. A real keyboard sends the ctrl and
    amiga key codes before it holds KCLK, so the combo tracking asserts
    reset first and amiga_service() blocks the main loop for 500ms inside
    amiga_assert_reset() - the keyboard's ~500ms hold begins and ends inside
    that blind spot. The single bit the hold strands in the ISR then offsets
    every following frame by one bit, permanently, and the autonomous
    hands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
2026-08-04 build: validate DISPLAY_CONTROLLER and expose the kbd-in timings
    DISPLAY_CONTROLLER was passed straight to add_compile_definitions, so
    -DDISPLAY_CONTROLLER=SH1106 (without the DISPLAY_ prefix) defined an
    unused macro, left the SH1106 blocks in disp_ssd.c switched off and
    built a working SSD1306 image with no signal at all - a 1.3" panel then
    comes up drawn with the wrong addressing mode and no column offset.
    Check it the way PORT2_ROLE is checked.
    The real keyboard hold timings are bench-tuning knobs, so give them the
    same option-style plumbing every other tunable here has instead of
    requiring -DCMAKE_C_FLAGS=-DKBDIN_RESET_HOLD_MS=400.
2026-08-04 util: correct the status led concurrency contract
    The header claimed every entry point was core0-only and left the
    impression that the setters and the task therefore never overlap. They
    do: pico_cyw43_arch_none pulls in the threadsafe-background async
    context, so BTstack packet handlers - and with them status_led_source()
    and status_led_pairing() - run from an interrupt which can preempt
    status_led_task() mid-update. It is the same reason bt_hid.c posts HID
    reports to a queue instead of bridging them inline.
    Nothing is broken today: the setters latch single words, the task alone
    drives the pins, and the worst case is one stale led frame. Say so, and
    mark the state the interrupt writes volat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
2026-08-04 bluetooth: dismiss pairing prompts that never become a connection
    The PIN and confirmation prompts were only cleared by an HID connection
    opening, closing or failing. An SSP attempt from a phone is auto-accepted
    and then simply never opens an L2CAP channel, which left the prompt on
    the display and - worse - left the pairing blink latched, since it takes
    absolute priority over the activity flash on led 2. The indicator stayed
    hijacked until the board was reset.
    Dismiss the prompt when a pairing attempt reaches any conclusion at all:
    simple pairing complete, authentication complete or disconnection.
2026-08-04 ci: drop the pull_request trigger
    pull_request filters on the base branch and was given the same branch
    list as the push trigger, so a PR into any of them would double every
    subsequent push: two full nine-combination matrix runs, each rev6 entry
    pulling the recursive pico-sdk submodules including btstack. This fork
    works in local commits; push and workflow_dispatch cover it.
2026-08-04 kicad: bootstrap rev6 project from rev5
    Start the rev6 board revision as a copy of the rev5 project under
    kicad/rev6/, leaving the rev5 sources byte-identical.
    - amigahid-pico-rev6.{kicad_sch,kicad_pcb,kicad_pro} copied verbatim from
    rev5; the .kicad_pro meta/filename and pcbnew last netlist path retargeted
    to the rev6 name. The root sheet UUID is left alone so it keeps matching
    the schematic.
    - Import the official Raspberry Pi Pico W symbol and footprint from
    VGA-PicoW-KiCAD.zip into project-local libraries: rev6.pretty and
    rev6-symbols.kicad_sym, registered under the nickname "rev6" in new
    project fp-lib-table and sym-lib-table files. Both upgraded to the
    current KiCad file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
2026-08-04 tools: add rev6 netlist checker
    cross-checks the rev6 schematic's exported netlist against the rev6
    connectivity spec, and the spec against src/config.h's BOARD_HIDPICO_REV6
    pin defines so the firmware map and the board stay one source of truth.
    written before the rev6 schematic exists: it currently fails loudly against
    the rev5-derived copy, which is the point.
    covers: U1 pad->net for all 26 gpios plus vsys/vbus/3v3/swd/tp2/tp3, the 19
    bss138 channels with their gate and per-rail pull-up pairs, every connector
    pinout (j1-j4, j7-j13, p1, p2), the f1/f2/f3 + d1/d2 power tree, usblc6,
    i2c pull-ups, usb-c cc pulldowns, led chains, jp1, bulk caps, 19 ground-clamp
    tvs parts, no-connect flags an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
2026-08-04 kicad: rev6 footprint library
    Prepare every footprint the rev6 schematic will reference. Standard KiCad 10
    libraries cover everything except three parts, which are drawn here from
    manufacturer drawings.
    rev6.pretty:
    * RPi_PicoW_SMD_TH - rebuilt from the official KiCad 10
    Module:RaspberryPi_Pico_W_SMD land pattern (RPi pico-w-datasheet: castellated
    edge pads, TP1..TP6, 4 USB shell ground pads, 2.4 GHz antenna and RF copper
    keep-out zones, suggested RF board edge) and grafted with the 40 through-holes
    from Module:RaspberryPi_Pico_Common_Unspecified, so every edge pin is both a
    2.54 mm through-hole and a castellation pad overhanging the module edge. The
    same PCB then takes a socke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
2026-08-04 kicad: rev6 symbol library for the schematic
    Prepare the project-local symbols the rev6 schematic needs.
    * PicoW gains the two USB test-point pins the rev6 footprint exposes - TP2
    (USB D-) and TP3 (USB D+) - so the netlist captures the slot and
    castellated half-via USB host tap instead of it living only on the board.
    An SH pin is added for the module's USB shell ground pads. All three pin
    numbers are the pad names already used by RPi_PicoW_SMD_TH.
    * PicoW: four electrical pin types corrected. The imported symbol declared
    36 (3V3), 39 (VSYS) and 40 (VBUS) as Unspecified and 38 (GND) as
    Bidirectional, which makes ERC blind to the module's role in the power
    tree. 36 and 40 are p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
2026-08-04 kicad: rev6 schematic
    Replace the rev5 schematic the rev6 project was bootstrapped from with the
    rev6 design. Flat single sheet (A1), wired by net labels in the rev5 style;
    every no-connect carries an explicit flag. ERC reports 0 errors and 0
    warnings; tools/check_rev6_netlist.py passes all 349 assertions against
    src/config.h and the rev6 connectivity spec.
    Gone from rev5: the J5/J6 IDC controller headers, the single unprotected +5V
    node, the IDC interleave compensation, and the 17-channel shifter bank.
    Power tree. AMIGA_5V (J1.4 || J9.5 || J10.4) -> F1 750 mA polyfuse -> D1
    SS34 -> SYS5V; the USB-C aux input feeds SYS5V through D2. SYS5V drives the
    module's VSYS (pin 39, not VBUS, so the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
2026-08-04 kicad: unmirror the DIN5 and mini-DIN6 land patterns
    Both project-local keyboard-connector footprints were built straight from
    their datasheet drawings without applying the bottom-view -> top-view
    mirror, so every pad X coordinate was negated with respect to the real
    socket.
    Orientation rule, calibrated against KiCad's own DSUB-9_Pins_Horizontal
    and DSUB-9_Socket_Horizontal (exact X-mirrors of each other, pin 1 at
    x=0 in both, mating face toward +Y, male pins 1..5 running with
    increasing X = pin 1 top-left in the front view, as a real DE9 male is):
    for a footprint whose mating face is at y=0 with the body at +y, an
    observer facing the connector sees left-to-right = DECREASING x.
    DIN5 (J9 O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
2026-08-04 kicad: graft the usb tap onto the pico w footprint, drop netless test pads
    The footprint carried KiCad's stock SMD test pads verbatim, so TP2/TP3
    (USB_DM/USB_DP) were 1.5 mm pads sitting flat underneath the module with
    no way to get solder to them - and they are the only path to the module's
    USB, which the whole USB-A host feature depends on. The planned slot and
    castellated half-via tap was never grafted.
    TP2/TP3 are now 1.6 mm pads on 1.3 mm drills at the module's own
    coordinates (+-1.0, -24.3), bisected by a 2.0 x 3.81 mm Edge.Cuts slot -
    rev5's proven geometry (its vias were 1.6/1.3 on a 1.778 mm slot),
    re-centred on the Pico W positions. The slot is a closed rectangle rather
    than rev5'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
2026-08-04 kicad: fix rev6 part numbers, packages and power tree
    Part numbers, all verified against the vendor/LCSC listing:
    - Q1-Q19 carried LCSC C82227, which is a TI HDC1080 humidity sensor in
    WSON-6, not a BSS138. Nineteen parts - the largest assembly line item -
    would have been rejected or populated wrong. Now C78284 (JSCJ BSS138,
    SOT-23).
    - D10-D28 paired the value PESD5V0S1BA with Diode_SMD:D_SOD-523. The -BA
    suffix is SOD-323 (1.7 x 1.25 mm body); it cannot sit on a SOD-523 land
    (pads at +-0.70 vs +-1.05). Footprint moved to D_SOD-323 and the LCSC
    placeholder replaced with the real stocked code C19224, which the plan
    wanted picked at this milestone anyway.
    - LED2 carried C2297 =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
2026-08-04 kicad: set jlcpcb fab rules and a power netclass for rev6
    The rev6 project settings were still rev5's byte-for-byte, including the
    min_copper_edge_clearance of 0.025 mm the plan calls out by name as the
    JLCPCB problem. DRC-clean at 0.025 mm is not the same board as DRC-clean
    at 0.3 mm, and reworking clearance after placement is expensive, so fix
    it before any routing rather than during M3.
    min_copper_edge_clearance 0.025 -> 0.3
    min_via_annular_width 0.05 -> 0.13 (JLC minimum ring)
    min_via_diameter 0.4 -> 0.6 (0.3 drill + 2 x 0.13)
    min_clearance 0.0 -> 0.2
    min_hole_clearance 0.25 -> 0.5
    min_hole_to_hole 0.25 -> 0.5
    min_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
2026-08-04 doc: scope the kicad ground rule to rev5 and track CLAUDE.md
    The ground rule still read "Never commit KiCad/board changes - firmware
    only", which is the exact opposite of what this branch has been doing for
    six commits, and the file was untracked, so neither the old rule nor a
    corrected one was in git at all. Any future session reading it would have
    been told to stop.
    The rule now says what is actually true: rev5 KiCad files are never
    modified, rev6 board work is committed under kicad/rev6/ on board-rev6.
    Adds the two gates every rev6 schematic change must pass (kicad-cli sch
    erc, tools/check_rev6_netlist.py) with the standing instruction to
    re-target rather than relax a checker assertion,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
2026-08-04 kicad: rev6 board bootstrap - placement, outline, keepout
    replace the copied rev5 board with a fresh rev6 layout built from the
    rev6 schematic netlist. all 115 footprints placed with refdes, value,
    LCSC/MPN fields and net-assigned pads; no tracks or pours yet.
    100 x 80 mm, 2 layers, 3 mm rounded corners, 4x M3 NPTH at ~4 mm
    corner offsets cut into Edge.Cuts.
    north J9 DIN5-OUT / J10 mDIN6-OUT, gap, J11 DIN5-IN / J12 mDIN6-IN,
    20 mm between connector centres, mating faces flush north;
    J1 and J8 1x8 headers inboard of their groups
    south P1 and P2 DE9 male, centres 24.0 and 76.6 mm (52.6 apart),
    hoods overhanging; J4 USB-A between them
    west U1 antenna end f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
2026-08-04 tools: add rev6 pcb checker
    structural assertions for the rev6 layout - the facts drc does not check.
    prefers the pcbnew bindings and falls back to reading the s-expression
    board file directly; both backends agree assertion-for-assertion.
    A one closed edge.cuts outline, cutouts allowed, size envelope
    B 4 npth/cutout mounting holes ~3.2 mm, one per corner
    C an antenna rule area >=14x9 mm on the board forbidding tracks,
    vias, pads, copperpour and footprints on every copper layer, plus
    a geometric test that no copper item intersects it on any layer
    D P1/P2 mate south, J9-J12 mate north ordered west to east with
    >=18 mm centres, J4/J13 mate outward, U1's antenna end a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
2026-08-04 kicad: fix rev6 placement ahead of routing
    J4 was fitted back to front: the Molex 67643 land pattern mates at its
    local +y, so the receptacle was pointing into the board and its pads sat
    2.8 mm from the south edge instead of 13.5 mm. Turned round and pushed
    out, which also brings the USB tap within reach - usb_dp/usb_dm could not
    have been routed under 25 mm the way it stood.
    Other placement work:
    - U1 1 mm north, opening a component band between the module and J4;
    R7..R14 follow so the SWD pads keep clear of R9.
    - U2 (USBLC6) and F2 to the top side as the layout brief requires, U2
    turned 90 deg so each USB line runs straight down one pad column
    from the tap to the connect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
2026-08-04 kicad: route rev6 board
    Copper for the whole board: 1524 track segments and 714 vias, 3.2 m of
    copper, plus GND pours on both layers (69% / 68% coverage) with 400-odd
    stitching vias on a 4 mm grid. Power runs at 1.0 mm on its own netclass,
    signals at 0.25 mm, +3V3 at 0.5 mm; the pours use thermal spokes on
    through-hole pads and solid connections on SMD.
    The shifter field had to be rearranged to make the board routable at all.
    As drawn at M2 all four BSS138 groups sat between U1's two pad rows, and
    the pull-ups lay flat at 1.6 mm pad pitch, which left 0.84-1.06 mm gaps -
    about 0.4 mm of usable lane once clearance comes off, so almost nothing
    could cross a pull-up row and the channels had to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
2026-08-04 kicad: finish the rev6 copper
    Pours re-laid with a 2.5 mm stitching grid (1028 ground vias, 69.3% /
    68.8% coverage), thermal relief tightened to 0.15 mm gap / 0.4 mm spokes
    so the through-hole ground pads keep two spokes, and the rail vias taken
    down to 0.6/0.3 - at 0.8/0.4 a handful sat 0.475 mm from a 0603 pad's
    copper where the copper-to-hole rule wants 0.5 mm.
    The USB pair is re-laid to swap sides on the back layer just in front of
    J4: U2 puts usb_dp on the west column and J4 on the east, so the pair has
    to cross once, and doing it under the board keeps both runs clear of each
    other. usb_dp 24.7 mm, usb_dm 22.8 mm.
    DRC is down to 2 starved thermals and 12 unconnected items; the detail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
2026-08-05 tools: check that every GND pad reaches the main ground island
    Section I proved a GND pour exists, is filled, covers enough of the board and
    has stitching vias. None of that notices a fill region that missed its via.
    This board's ground carries no tracks at all - it is pour plus 1300 stitching
    vias - so such a region is a dead node, and DRC only reports it as an anonymous
    "Zone GND F.Cu <-> Zone GND B.Cu" ratsnest line that names no part.
    I5 unions the GND fill polygons, pads, tracks and vias into electrical islands
    (vias and PTH pads bridging the layers) and asserts every GND pad lands on the
    largest one. On the current board it names the four it should:
    D23 pad 2, D25 pad 2, D26 pa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
2026-08-05 kicad: rf board keep-out, shifter designators and jlc-legal silk
    Layout review fixes that touch no signal copper. DRC is unchanged by this
    commit: still the same 2 starved thermals on U1 pad 28 and the same 12
    unconnected items, and no new violation of any other kind.
    Outline
    - Cut the west edge back to x = 8.5 mm between y = 43.71 and 58.81 with R1
    inner fillets. Raspberry Pi's own Pico W footprint carries a "Board Keep
    Out Suggestion RF" rectangle on Edge.Cuts reaching 8.5 mm inboard of the
    antenna end: the carrier is meant to be cut away under the antenna, not
    merely kept free of copper, and the board only overhung it by 1 mm. The
    strip lies between the module's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
2026-08-05 kicad: thin the rev6 stitching via field
    the board carried 1021 ground stitching vias on a 2.5 mm grid. with
    min_hole_clearance at 0.5 mm that is a pegboard: every corridor a signal needs is
    fenced off by via holes, which is why eight nets were still open and four ESD clamps
    were sitting on pour islands of their own.
    the layout plan only asks for a tie about every 10 mm in open regions and the checker
    only wants fifteen, so the field goes. what is left are the vias that carry a stub -
    clamp anchors and island ties - and the ties the stitcher then adds to keep the plane
    one electrical island. 1021 vias down to 25.
    no net changes: the same twelve items are unconnected before and after.
2026-08-05 kicad: move the esd clamps to the pins they protect, and re-lay the copper
    the clamp rows were laid out in designator order rather than connector-pin order, so
    a clamp could sit 19.2 mm from the pin it protects with the stub running past the
    level shifter it is meant to shield. D22 was 19.22 mm from P2 pin 5, D28 19.12 mm
    from P2 pin 1, D13 16.92 mm from P1 pin 4. each row is now re-ordered to follow its
    connector's pin order and pulled up against the connector, and the outer clamps are
    mirrored so the signal pad always faces its pin. worst stub 19.22 mm -> 7.05 mm.
    U2's two I/O columns were mirrored with respect to J4, so the differential pair
    crossed over between the filter and the soc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
2026-08-05 kicad: stitch the rev6 ground back in and finish the copper
    ground last, on an 8 mm grid rather than the 2.5 mm one it started with: 18 clamps get
    their own anchor via before anything else, then the grid, then the leftover pour
    islands are tied in. 114 vias where there were 1021, and every via is now placed with
    the signals already down instead of the other way round.
    the module's ground pads, J2's, J4's and P1's shell came up as starved thermals - the
    pour can only reach them from one side, so DRC called the relief incomplete. they are
    ground pads on a ground plane and the module is reflowed by its castellations or
    socketed, so they get a solid zone connection rather than two 0.5 mm spok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
2026-08-05 kicad: drop the duplicated rev6 copper and trim the dead stubs
    444 of the board's 2075 track and via objects were exact duplicates - same net, layer,
    endpoints and width, stacked on top of each other by the successive re-lays. they are
    gone, which is most of the -4158 lines here. they also explain why the last pass could
    not clean up the dangling stubs: every stub had a copy of itself lying on it, so a
    "does anything else touch this?" test always answered yes.
    three stubs are trimmed back to their last live junction rather than deleted, because
    each carries a junction partway along and deleting it - which is what the DRC line
    suggests, since it reports the track's start, not its free end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
2026-08-05 kicad: move the esd clamps off the de9 pins and close /kbdata
    all three gates are green after this: DRC 0 violations / 0 unconnected, check_rev6_pcb
    32/32, check_rev6_netlist 356/356.
    the clamp rows under P1 and P2 move 0.6 mm north. they were 0.395 mm from the DE9
    through-hole pads - under JLCPCB's 0.4 mm solder-mask dam, and with no room to get an
    iron onto the DE9 pins - and six of those pads' mask openings clipped a clamp body
    outline, which is where the 14 silk_over_copper lines came from. the copper gap is now
    0.995 mm and the silk clears the mask by 0.295 mm. the whole row moves, not just the six
    offenders, so it is still a straight row.
    every clamp now owns a ground via with a 0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
2026-08-05 kicad: widen the power via transitions and shorten the decoupling returns
    all three gates stay green: DRC 0 violations / 0 unconnected, check_rev6_pcb 32/32,
    check_rev6_netlist 356/356.
    every power layer transition was a single 0.6/0.3 via and the input current crosses two
    of them in series. the Power netclass asks for 0.9/0.5 and nothing was using it, so the
    three transitions with the room are widened to it, and 22 more vias go in beside the rest
    - three per transition where they fit - tied on both layers by 0.8 mm links, which is what
    F2 wants of a power segment. /AMIGA_5V_FUSED, /KBIN_5V and the two busiest /USBA_5V and
    /SYS5V transitions now carry three barrels each instead of one.
    C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
2026-08-05 kicad: give the usb pair a ground reference on the other layer
    only 11-16% of usb_dp/usb_dm had ground under them on the other layer. the corridor
    beneath the pair is the board's main east-west channel on B.Cu - +3V3, SYS5V, USBA_5V,
    swdio and five of the _lo nets all cross it - so the pour cannot get in, and re-pathing
    the pair means moving that channel.
    instead the pair gets a ground shadow: 10.1 mm of track on the other layer following it,
    laid in the stretches that are legal and stitched to the plane at the end of each stretch
    with 7 vias. the return current now has somewhe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
2026-08-06 kicad: keep the bottom side flat — move the usb bulk cap topside
    all three gates stay green: DRC 0 violations / 0 unconnected, check_rev6_pcb 33/33,
    C4, the 150uF USB-host bulk can, was the only thing on the bottom taller than about a
    millimetre - a 6.3 x 7.7 mm CP_Elec against a field of 0603s, 0805s, SOT-23s and
    SOD-323s - so the board could not sit flat on that face. it moves to the top at
    57.400,64.400 at rot 0, pad 1 (+, USBA_5V) west at 54.700,64.400 and pad 2 (-, GND)
    east at 60.100,64.400.
    that puts it 10.29 mm from J4 pin 1, against 8.04 mm on the bottom. it is the closest
    legal top-side spot: the courtyard is 9.49 x 7.19 mm and the only band that w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
2026-08-06 tools: assert a low-profile bottom side
    E4: every footprint on B.Cu has to match one of a whitelist of low-profile packages -
    SOT-23, SOD-, R_0603, C_0603, C_0805, LED_0603 - and anything else fails by refdes.
    a whitelist rather than a list of tall packages, because the failure mode is somebody
    putting a can, a radial or a through-hole part on the face the board rests on and nobody
    having thought to name that package in advance.
    the model gains the footprint's library id, filled in by the pcbnew backend and by the
    s-expression reader alike, so the check holds either way.
    against the board at the previous commit it fails and names C4
    (Capacitor_SMD:CP_Elec_6.3x7.7 on B.Cu) on both backends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
2026-08-06 tools: measure the usb bulk cap, and pin the rev6 project settings
    all three gates stay green: DRC 0 violations / 0 unconnected / 0 schematic
    parity issues, check_rev6_pcb 33 -> 38/38, check_rev6_netlist 356/356. no
    board and no schematic change - both halves of this are gate work.
    E5, the usb-host bulk cap. the layout brief wants C4's USBA_5V pad within
    6 mm of J4 pin 1; the board is at 10.29 mm, and nothing in the gate said so.
    section E only checked which side parts sat on, the FET count and the
    bottom-side package whitelist, so 33/33 PASS was silence about that rule
    rather than confirmation of it. E5 measures the distance and prints it on
    every run, brief figure alongside, so the dev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
2026-08-06 tools: add rev6 routing style checker
    the rev6 tracks were laid by a grid maze router, and it shows: the copper is
    electrically right and visually wrong - near-45 diagonals that are not 45,
    and short jogs laddering their way across the board. DRC, check_rev6_pcb and
    check_rev6_netlist are all silent about it, because none of them has any
    opinion about what routing should look like. this makes "professional
    routing" a number instead of a matter of taste.
    S1 >=99.0% of routed track length on a multiple of 45 deg, 0.5 deg
    tolerance, segments under 0.5 mm exempt as pad exits. prints the
    percentage and the top 20 offending nets by off-angle length, with
    coordinates.
    S2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
2026-08-06 kicad: re-lay the ground ties on 45-degree runs
    GND is a poured net: its tracks are the short links between a pad and the
    stitching via that takes it to the plane on the other side. Forty-two of the
    fifty-three segments sat at whatever angle the maze router left them at, which
    is 54 mm of copper wandering across the board at 5 to 20 degrees off.
    Each chain is now torn out and laid again between the same two anchors, as one
    straight run or an orthogonal and a 45. Where the two anchors are a few
    hundredths off an exact 45, the tie lands a hair off the pad centre rather
    than growing a 50 micron leg to make up the difference - a tenth of a
    millimetre inside an 0.8 mm pad is still dead on it.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
2026-08-06 kicad: pin real part numbers across the rev6 bom
    the last five TBD entries get real, in-stock lcsc codes: C1 220uF and C4
    150uF become panasonic FK cans (C128533 / C413656) on the 6.3x7.7 land,
    and the three polyfuses become the bourns MF-MSMF parts their MPN fields
    already named (F1 750mA C84140, F2/F3 500mA C17313).
    everything that is hand-soldered - all thirteen connectors, the pico w
    module and the solder jumper - gets a Sourcing field instead of an lcsc
    code, so jlc never sees them and nobody has to guess later. the DE9 line
    is the one worth reading: the board's land is the 5.0 mm footprint, so
    the common 0.318 in parts do not fit.
    fields only, no connectivity touched. the pcb footpri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
2026-08-06 kicad: void the module test-pad copper and tidy the rev6 board
    the flat-mount build rests the pico w's bare underside test pads on the
    carrier with nothing but solder resist between them, and rev6 was running
    live copper under three of them: /cont1_v crossed tp6 (bootsel / qspi_ss),
    /cont1_v_lo and /cont1_v crossed tp5, and ground pour filled tp4. tp6 held
    low is an rp2040 that boots to mass storage for ever, and /cont1_v is a
    5 v-side node pulled to sys5v, so that pad could also see overvoltage on a
    3v3 pin. doc/errata.md already records the same class of fault on rev4.
    so: both crossings move out, and an f.cu rule area at x 35.40-42.50,
    y 47.76-49.76 keeps tracks, vias and pour out for go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
2026-08-06 tools: re-baseline the netlist-checker guard after the f1 retarget
    j3 pins tools/check_rev6_netlist.py to its m2 blob so nobody can quietly
    weaken it, and 84f2598 changed that file - so the guard fired, exactly as
    designed. re-pinned to 84f2598, with the reason recorded next to the
    constants: the f1 rule was re-targeted, not relaxed. it used to warn when
    f1's value was *not* 750 ma, which blessed the very placeholder the design
    gates on; it now asserts that while the draft value stands f1 must carry
    no lcsc code. that is one assertion more than before, 356 -> 357.
    check_rev6_pcb goes back to 38 of 38.
2026-08-06 doc: write down the rev6 build notes and the fourth board gate
    errata gets a revision 6 section. it is not a list of mistakes found after
    the fact - the board is not fabricated - but the things that will bite a
    builder: the module test-pad copper void and the one position (a plain
    pico's tp4) that could not be cleared; that pico, pico w and pico 2 w in
    fact share tp1/tp2/tp3 and all four usb shell pads, so the usb tap works
    on a plain pico and the only real plain-pico loss is swd; that f1 must not
    be ordered assembled; that j4's mating face hangs ~4 mm off the board edge
    and wants supporting; the 3.68 mm between the usb-a opening and each de9
    flange; that the de9 ports take no power, so cabl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
2026-08-06 kicad: move the north connector labels inside the boxes they name
    j9-j12 are the four parts a builder most needs to identify and their
    designators sat in the ~2.5 mm channels between the silk boxes, reading
    equally as a label for either neighbour - j10's was 4.08 mm from its own
    pads and 4.41 mm from j9's, j12's the same against j11. all four now sit
    inside their own outline, 0.90 mm from a pad of the connector they name,
    with their own part nearest by a clear margin.
    gates: kicad-cli drc 0/0/0, check_rev6_pcb 38/38, check_rev6_netlist
    357/357. check_rev6_style unchanged: s3 green, s1 and s2 still red on the
    inherited routing.
2026-08-07 kicad: re-lay the rev6 copper on 45-degree runs
    the rev6 tracks came off a grid maze router: electrically right, but laid at
    whatever angle got round the next obstacle. check_rev6_style.py has measured
    that since it was added and had never passed - 38.416% of the routed length sat
    on a multiple of 45 degrees where s1 asks for 99%, with eight ladders of
    sub-millimetre jogs on top of it. that gate was authored against copper already
    at 34.61% and stayed red through every commit since, so it was never a
    regression to fix; the board simply had to be re-laid.
    every track is re-laid. the topology is taken from the copper that was already
    there - which layer, which via, which pad, which junction -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
2026-08-07 kicad: make the rev6 power netclass live and route the rails to it
    net_settings.meta.version was 2 while membership was expressed with
    netclass_patterns, which is a v3 construct. on load kicad runs its v2 -> v3
    migration, builds membership from classes[*].nets - absent here - and overwrites
    the hand-written patterns with the empty result, so every supply rail resolved
    to Default and every rev6 drc run recorded in a commit message so far measured
    the supply copper against Default's 0.20 mm rather than Power's 0.25 mm. the
    netclass has been decorative since f5677cb added it, and the file has been at
    version 2 since it was bootstrapped from rev5 at 8811818.
    bumping the version to 3 makes it li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
2026-08-26 kicad: credit r6 and link the fork on the silkscreen
2026-08-26 doc: add the mouser bom next to the rev6 board files
2026-08-26 kicad: rename the board to ux, drop the unsupported license line
    silkscreen title is now "hid-pico Amiga UX", revision line "UX rev 1 - by
    Jusii". the license assertion is removed: neither repo carries a license
    file and both readmes point at epl-2.0 (tentative), so the board no longer
    claims what no document supports. checker H2 re-targeted from the r6
    marker to the UX product/revision marker in the same commit. the de9
    footprint gains the verify-against-sample marker and the p1/p2 sourcing
    fields get the corrected caliper dimensions (near pin row 7.78 mm, flange
    holes 4.94 mm).
2026-08-26 doc: fix the first-power sequence, the de9 sourcing and the export footgun note
    f1 ships unfitted, so the bring-up now starts at the usb-c aux input
    (current-limited), sizes f1 from the measured stack draw and hand-fits it
    last. the mouser bom de9 line pointed at the 9.4 mm european family which
    does not fit this board (5.34 mm footprint, flange holes through the pcb)
    - corrected, with the wrong parts named. claude.md: kicad-cli pcb export
    gerbers also rewrites the project file; gate count fixed to four.
2026-08-26 kicad: retarget the de9 land to the .318in family
    the rev6 DE9 land only ever matched Power Dynamics PDI-09S-5: a 5.34 mm
    footprint with its boardlock holes collinear with the near pin row, which
    is a PDI-proprietary trait, and the part is dead and unobtainable. retarget
    P1/P2 to the industry .318in/8.08 mm family, whose boardlock holes sit
    midway between the pin rows. primary buy is Kycon K22X-E9P-N; NorComp
    182-009-113R531, TE 5747840-x, Wurth 618009231221 and Amphenol L717 code
    33E are drop-in.
    * footprint renamed to the stock KiCad variant name
    EdgePinOffset7.70mm_Housed_MountingHolesOffset9.12mm, with its
    drawing taken from that variant: body, flange and boardlock legs all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
2026-08-26 doc: point the de9 sourcing at kycon
    follows the land retarget in 700f727. the bom and the errata still told
    whoever buys the parts to look for the 5.34 mm power dynamics land, which
    is both wrong for the board now and dead as a part.
    * bom md + csv: P1/P2 is Kycon K22X-E9P-N, Mouser 806-K22X-E9P-N with
    a Digi-Key FI fallback, and the substitution rule in note 4 is now
    "boardlock holes midway between the pin rows", not a backset figure.
    NorComp 182-009-113R531, TE 5747840-x, Wurth 618009231221 and
    Amphenol L717 code 33E are called out as the same land. the Triopak
    RP94s already on the shelf are the 9.4 mm european family: spares,
    do not fit.
    * errata: a new rev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
2026-08-26 doc: add a mouser bom-import cart csv
2026-08-26 doc: swap out-of-stock mouser parts, fix the f1 low candidate to msmf030
    msmf035 never existed in the bourns line - the 350 ma prediction in the
    plan became a phantom part number; the real low candidate is msmf030
    (300 ma hold). caps swapped to murata/kemet, ss34 to the diodes inc
    b340a-13-f, the esd clamps to bourns cdsod323-t05c (nexperia ,135
    packing as alternate), the cc resistors to panasonic erj-3ekf5101v.
    cart csv customer part numbers now carry the AmigahidUX mark for
    labeled bags.
2026-08-26 doc: drc --save-board also migrates the project file on kicad 10, and nfs delays the evidence
2026-08-26 doc: cut the cart csv to exact one-unit quantities
2026-08-26 kicad: freeze the ux rev 1 fab package
2026-09-27 kicad: mount the oled on a socket and two posts
    the 0.96in ssd1306 module now plugs straight down onto the board instead of
    hanging off wires: J3 becomes a 1x4 female socket at the module's header edge
    (pins x 81.74-89.36, y 40.5) and two M2 posts hold the east edge, H1 (97.3,
    40.5) and H2 (97.3, 64.3), 2.2 mm NPTH, board-only footprints. the module
    sits at x 71.8-99.3, y 38.5-66.3, flush inside the east edge. the other two
    corners get no post on purpose: the lower-left one lands on Q18 and six
    port-2 nets, the upper-left one sits in the corridor the i2c pair crosses.
    * J3's pin order is the module's, GND VCC SCL SDA, so pins 1 and 2 swap
    nets in the schematic (was 3V3 GND SCL SDA);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
2026-09-27 tools: pin the netlist checker's oled-socket re-baseline
    check_rev6_pcb.py J3 now points at ec09905, the commit that re-targeted J3's
    pin map to the socket's order; blob and commit agree again and the board gate
    is back to 38/38.
2026-09-27 kicad: keep the oled socket's silk at the 0.15 mm floor
    the stock PinSocket footprint draws its outline at 0.12 mm, below the jlcpcb
    silk floor the rest of the board holds; J3's six strokes go to 0.15.
    gates: drc 0/0/0 parity; check_rev6_pcb.py 38/38; check_rev6_netlist.py
    357/357; check_rev6_style.py 4/4.
2026-09-27 kicad: re-cut the ux rev 1 fab package for the oled socket and posts
    gerbers + drill regenerated from 031f865 with the same layer set and options as the
    previous freeze (kicad-cli 10.0.6): 495 drill hits, 11 tools, the two Ø2.2 mm
    M2 posts are the package's first NPTH entries, Edge.Cuts unchanged byte-for-byte
    bar the date header. ORDER-CHECKLIST.md brought in line with the board as it
    is now - it still described the 100 x 80 mm pre-retarget outline, told the reader
    to fit the 9.4 mm DE9 family the board no longer takes, and carried the old drill
    table; those are corrected along with the silk, USB-A overhang and OLED mount
    notes.
2026-09-28 doc: pin the oled socket at the 8.4 mm part in hand
    posts stay 11 mm (8.4 + 2.54 = 10.94; the socket contacts take the rest).
2026-09-28 kicad: add the 1:1 fit-check template and the bare-board step/stl
    fit-check-1to1.pdf: A4 landscape, board at 100 % with every drilled hole from
    the frozen drill file at finished size plus outline and top silk, and a 50 mm
    scale bar to verify the print before trusting it. mech/: board-only STEP and
    STL (outline, slot, notch, all holes, no components) for the case.
2026-09-28 kicad: 3d models for the din sockets, the oled and its posts
    kicad's library has no din5 / mini-din6 sockets and no generic 0.96in oled
    module, so rev6.3dshapes/ carries dimensioned vrml blocks built from the
    footprint datasheets: kycon kcdx-5s-n (20.5 x 15.5 x 19.5), same sky md-60s
    (14 x 12.4 x 12.8), the module on 11 mm posts (27.5 x 27.8 pcb at 10.94,
    glass and active area per the module drawing) and the m2 posts. render-only
    (vrml is not carried into the step export); the board-only step in mech/ is
    unaffected.
    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
2026-09-28 kicad: step models for the din sockets, oled and posts; full assembly step/stl
    the vrml blocks become step (built with cadquery from the same datasheet
    dimensions, with socket bores and the module's post holes), so kicad's step
    export now carries every part: mech/hid-pico-amiga-ux-rev1-assembly.step/.stl
    is the board with all connectors, the pico, the oled on its 11 mm posts and
    the smds - the thing to design the case around. the board-only files stay.
    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
2026-10-12 build: update SDK and external dependencies
    Update Pico SDK to 2.3.1, TinyUSB to 0.21.0 and CYW43 to 2.0.0.
    Pin TinyUSB and CYW43 as upstream submodules and select them through
    the SDK's path overrides.
    Use the explicit USB host initialization API and document the
    independent dependency checkouts. Keep BTstack, lwIP and Mbed TLS at
    the SDK's release pins without dependency source patches.
2026-10-12 bluetooth: follow btstack's removal of the report-with-fallback mode
    the pico-sdk 2.3.1 btstack pin drops HID_PROTOCOL_MODE_REPORT_WITH_FALLBACK_TO_BOOT
    (btstack 640945cec). ask for REPORT: btstack runs the sdp/descriptor path and the
    device's actual mode arrives in the set-protocol response, which the classic
    connection table already tracks and the boot-report parser already honours.
    all eight ci configurations build against sdk 2.3.1 / tinyusb 0.21.0 / cyw43 2.0.0.
2026-10-13 bom: audit against the board
2026-10-13 doc: readme and ux rev 1 board guide
2026-10-13 doc: board photos
2026-10-13 doc: add interactive bom
2026-10-13 bom: shorten descriptions
2026-10-13 doc: rename to amigahid-pico-ux
